dendenpixel/sumobot-must-be-the-wind/hardware/cad/v11/layout/plan.png

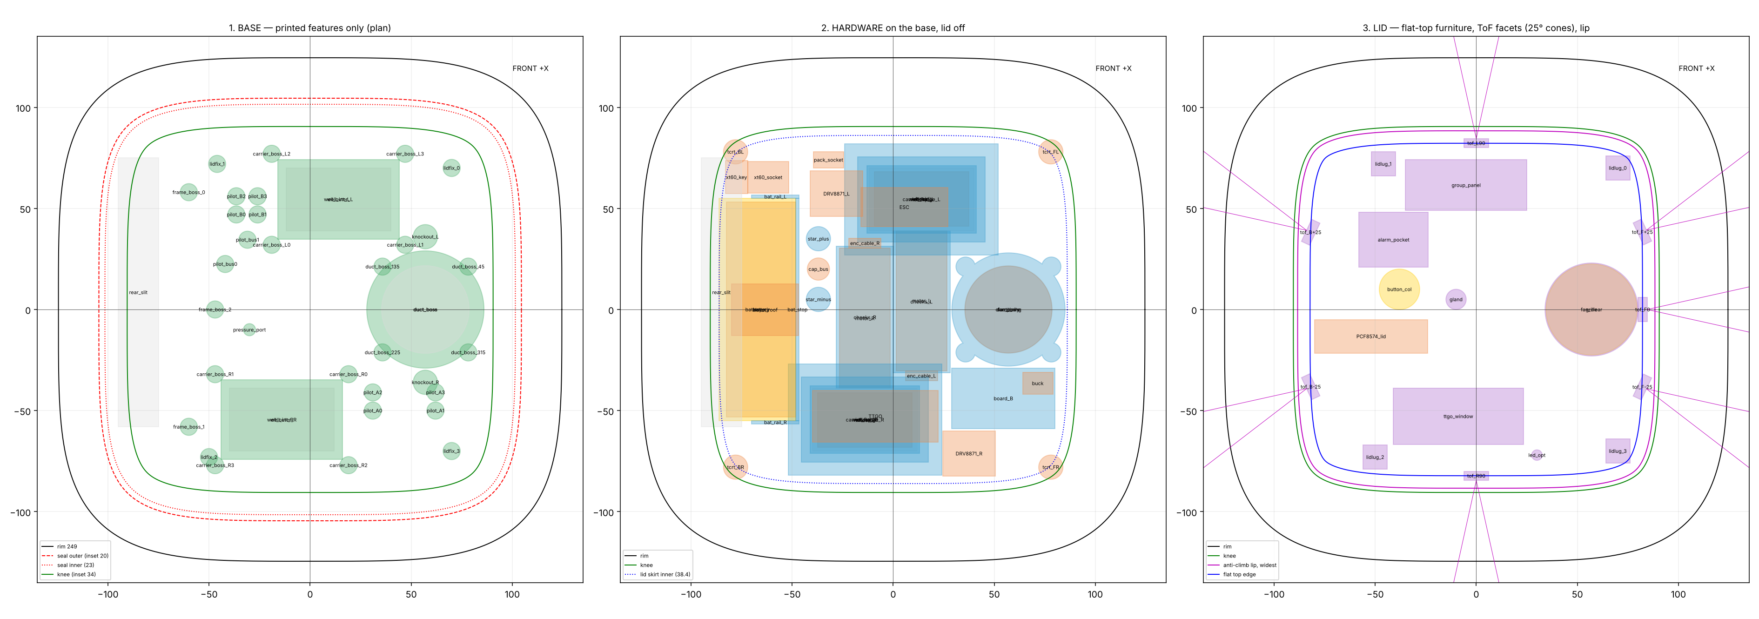
hardware/cad/v11/layout/plan.png
