dendenpixel/sumobot-must-be-the-wind/hardware/cad/v11/layout/zstack.png

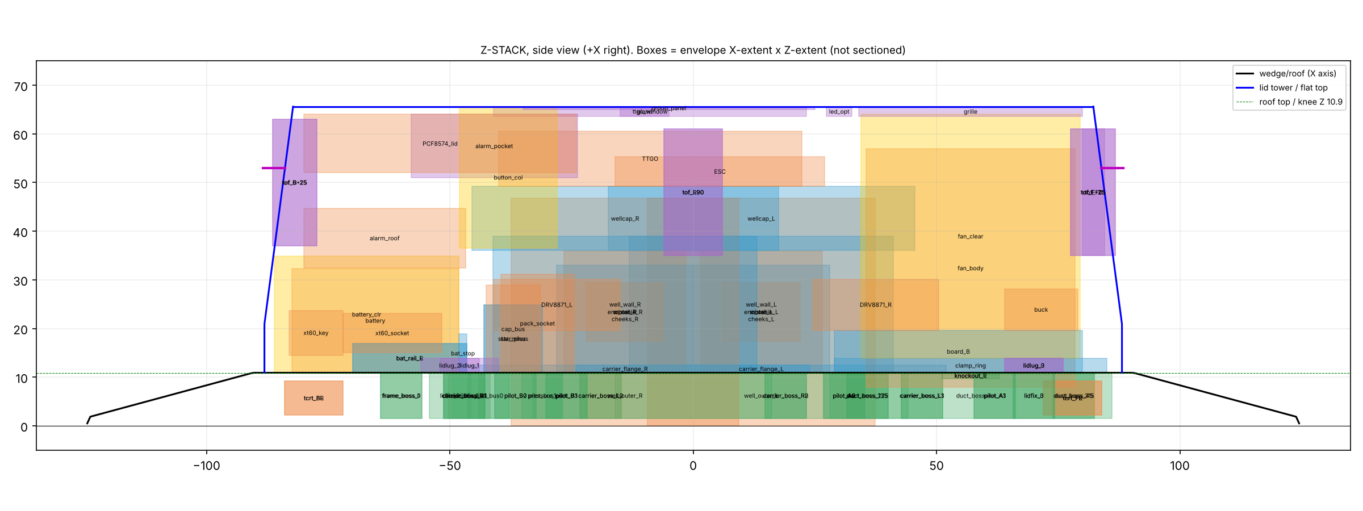
hardware/cad/v11/layout/zstack.png
