dendenpixel/sumobot-must-be-the-wind/media/first-drive/mass_765g_2026-09-23.jpg

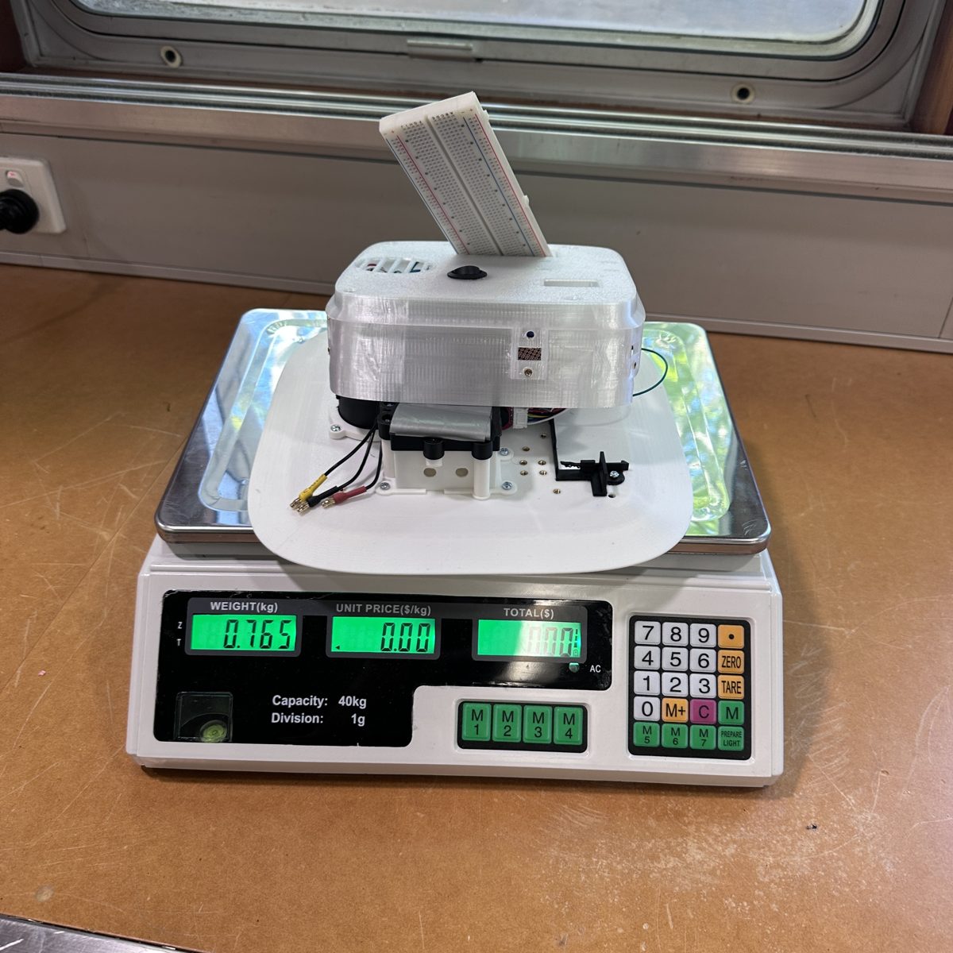
media/first-drive/mass_765g_2026-09-23.jpg
