dendenpixel/sumobot-must-be-the-wind/(list of files, cad)

Other CAD files:
hardware/cad/v11/step/v11_assembly_full.step
hardware/cad/v11/step/v11_base.step
hardware/cad/v11/stl/clamp_ring_v2_earslot_shrinkcomp.stl
hardware/cad/v11/step/v11_lid.step
hardware/cad/v11/stl/clamp_ring_v2_shrinkcomp.stl
hardware/cad/v11/stl/v11_battery_frame_v2_clip.stl
hardware/cad/v11/stl/tyre-ring-mould.stl
hardware/cad/v11/stl/sumo_wheel_hub_v6_2.stl
hardware/cad/v11/stl/v11_wellcap_L_plus2.stl
hardware/cad/v11/stl/v11_wellcap_R_plus2.stl
hardware/cad/v11/stl/v11_base.stl
hardware/cad/v11/stl/v11_lid.stl
