dendenpixel/sumobot-must-be-the-wind/docs/chassis/archive/v5-v8_POSTMORTEM.md

> **Superseded 12 Sep 2026.** The chassis is v11 (`docs/chassis/v11/START_HERE.md`). Kept for the reasoning/history.

# SumoBot chassis — v5 → v8 post-mortem and CAD handoff

**Sumo Bot · Semester 2 2026 · group project**
**Written 11 Sep 2026 at the end of an AI-assisted CAD session, for the next CAD session.**

---

## How to read this

Sections **1–9 are what you need to make decisions and build.** Sections **10–17 are why**, and the
appendices are the evidence. If you read nothing else, read §1, §2, §5 and §7.

Four CAD generations were attempted in one day. **v5 was printed and is a real object.** v6, v7 and
v8 were generated by separate max-reasoning CAD sessions and all three were rejected. Every
generated build was watertight and analytically correct — **none of them failed because the
generator was bad.** They failed because the *brief handed to the generator was internally
inconsistent*, in ways this document enumerates exhaustively so you do not repeat them.

**Two warnings about this document itself:**

1. The numbers in §15 are **corrections to numbers that were previously stated as facts.** Several
   were quoted in the v6/v7/v8 briefs and are wrong. If you find a figure elsewhere that contradicts
   §15, §15 wins.
2. This document is a *handoff*, not a requirements source. The requirements in §2 are reconstructed
   from the competition brief and the team's own planning docs. **They need confirming before any build.**

---

# 1. State of play — read this first

## 1.1 What actually exists

| Artefact | Status |
|---|---|
| **v5 chassis** (`sumo_v5_housing.3mf` + `sumo_v5_cover.3mf`) | **Printed. Weighs 267 g.** Has three defects that make it unusable as-is — see §1.2 |
| v6 base | Generated, **rejected** (battery tub inside a wheel well, + 8 more) |
| v7 base | Generated, **rejected** (38 overlapping envelope pairs) |
| v7 lid | Generated, **rejected** — 31 findings (23 constraints + 8 contradictions), incl. a 90° print ledge |
| v7 lid **rev A** | Patched in-place, **best lid so far** — 10 open constraints |
| v8 base | Generated, **rejected** — 12 register findings, 9 still open |
| **A printable chassis** | **Does not exist.** |

**Three things must be settled before any CAD starts, and none of them is a measurement:**

1. **DEC-13 — the battery hatch does not work as specified.** R16 is currently unsatisfiable: the
   pack would have to rise 18.1 mm to clear the sill and has 2.64 mm of headroom. **§16.4** has the
   arithmetic and three options. *This was not noticed until the final review of this document.*
2. **DEC-14 — the tower `lean` has no agreed value.** v7/v8 used 10°, lid rev A used 5°. Everything
   above Z 20.90 depends on it, including the anti-climb lip (#31).
3. **DEC-8 — the base drills 6 lid pilots and the lid uses 4.** Freeze it in §7 first.

**There is no base/lid pair that has ever been built against the same interface contract.** v8 BASE
and v7 LID rev A are from different generations. §7 fixes this.

## 1.2 Why v5 cannot just be reprinted

Measured off the meshes directly (not read off a self-check panel):

- **The wheels do not touch the ground.** Saddle floor Z 13.35 + a Ø25 motor can holds the axle at
  Z 25.85; the wheel radius with tyre is 23.40. **Wheel bottom sits at Z +2.45.** The bot rides on
  its rim and skirt.
- **The wheel wells are open holes straight to the arena floor, inside the seal loop** — 3,599 mm²
  against a design leak budget of 382 mm². **9.4× over.** The fan, the ESC, the 30 A wiring and the
  battery upgrade were producing approximately **zero** downforce.
- **The new battery does not fit.** The pack that arrived is 106.29 mm long against a 75 mm bay —
  **31.29 mm too long.**

That is what justified the rewrite. It is also the only time in this project anyone **looked at the
geometry** rather than reading a panel of numbers, and it produced three defects four rounds of
self-checks had missed. See §17 stage 6.

## 1.3 The two gates that can delete this design

| Gate | When | Rule | Consequence |
|---|---|---|---|
| **Fan kill gate** | **14–20 Sep, i.e. next week** | `<0.9 kg gain on the scale`, or `<60 mm H₂O`, or `EDF >100 °C in 3 min` → **fan off** | The plenum is the reason this chassis is shaped the way it is. If the gate fires, the architecture becomes *990 g ballast + silicone tyres + sprung lip* and most of §7 is irrelevant |
| **First drive** | **21–25 Sep (dry run Wed 23)** | "a platform with motors and wheels driven from the ESP32: 1 m forward, stop, 1 m back, stop" | **This does not need the plenum, the lid, the ToF, the pods, the fan, the skirt or the seal.** It needs a rolling platform. |

**Read those two rows together.** Ten days before a milestone that needs only a rolling platform,
a week before a gate that could delete the downforce architecture, the effort went into a sealed
pressure vessel with six ToF sensors. **That is the real failure of 11 Sep**, and no amount of
improvement to the CAD method catches it. See §17.0.

## 1.4 Ownership

Ownership as the master plan had it on 11 Sep, since superseded: CAD and printing moved to Den.

## 1.5 The next 48 hours — do these before any CAD

Four of them are caliper work and take under an hour total. Three of them **block real design**.

| # | Action | Blocks | Time |
|---|---|---|---|
| 1 | **Weigh both motors, one wheel with tyre, the ESC** | 330 g of the mass budget rests on seller estimates; **motors alone are 190 g = 20 % of the robot**, and the old pair measured 39.29 mm (310-class, not the assumed 371) so they are probably lighter | 2 min |
| 2 | **Measure `tyre_w`** (tyre width on the wheel) | Well Y depth, wellcap size, and **check D5 — which "passed" in v8 only because `tyre_w = 30.0` was assumed** | 1 min |
| 3 | **Measure `btn_panel_t`** (the panel thickness the power button's snap clips grip) | The button mount entirely. No hole tuning fixes a clip-range miss | 1 min |
| 4 | **Measure the bare TCRT5000** (desoldered off the module) | Corner pod pocket depth has **0.10 mm of margin** on the datasheet figure | 2 min |
| 5 | **Measure the wheel's CAD bore value** | Turns `hole_shrink = 0.21` from an estimate into a constant | 1 min |
| 6 | **Confirm the PCF8574 count** — one, not four | Decides whether the electronics fit on the roof at all | ask |
| 7 | **Confirm the TTGO is physically on hand** | Rule-mandated part; never confirmed by anyone | look |
| 8 | **Print the hole-shrinkage coupon** (4.00 / 4.15 / 4.30) | Sets `hole_shrink` for every other number on the bot | 20 min print |

---

# 2. Requirements

**This section did not exist in any previous brief.** Every number that follows in §5–§9 is a
*specification* — a value chosen to satisfy one of these. If a spec and a requirement conflict, the
requirement wins and the spec gets recomputed. Nothing gets built that does not serve a row here.

## 2.1 Rule-mandated — non-negotiable, checked by staff

| ID | Requirement | Source | Verified by |
|---|---|---|---|
| **R1** | **Mass ≤ 1000 g.** Working target 985–995 g | competition brief, "these will be checked!" | scale at weigh-in |
| **R2** | **Fits 250 × 250 × 250 mm**, including skirt and EDF guard. Build to 243 mm | competition brief | box check |
| **R3** | **Own chassis, built from scratch.** No published designs | competition brief | inspection |
| **R4** | **TTGO ESP32 controls the vehicle** | competition brief | demo |
| **R5** | No commercial boards **except the motor controller** | competition brief | inspection |
| **R6** | **Must indicate a detected opponent** on the display or a dedicated LED | competition brief | demo |
| **R7** | **Must clearly show the group number** on the robot | competition brief | inspection |
| **R8** | Must not drive outside the white line | competition brief | bout |

> **R6 and R7 have physical CAD consequences and were nearly deleted.** The group-number panel
> (60 × 25 × 0.6 recess at (20, 0) in the flat top) appears in the v7/v8 lid brief **only as
> failure #27** — "Group panel overlaps the EDF grille by 18.5 mm". A reader resolving #27 by
> deleting the panel fails R7. The opponent LED (Ø5.2 at (−20, 0)) is likewise a single line.
> **Neither is optional.**

## 2.2 Functional — how it wins

| ID | Requirement | Source | Spec that serves it |
|---|---|---|---|
| **R10** | Push a stationary object out of a 1 m ring, **fast** — the push-out time seeds the competition bracket | brief: 30 % functional + 25 % competition; time seeds the bracket | downforce plenum, μ ≥ 1.0 tyres, ballast to 990 g |
| **R11** | Find the opponent anywhere in the ring | brief: "must find any other robot" | ToF array (DEC-6) |
| **R12** | Detect the white line and not self-out | brief | 4 corner line sensors (DEC-7) |
| **R13** | **Get under the opponent** — "angled front helps in pushing/flipping"; last year's winner ran one print layer off the ground | competition brief hints + an early practical | the 15.14° full-perimeter wedge, rim lip underside Z 0.50 |
| **R14** | **Resist being lifted/wedged.** This, not tipping, is the real loss mode — tipping a 1 kg bot with a Z 21 mm CG needs >120 N | v6 review §7 | anti-climb lip, hard rim, low CG |
| **R15** | Survive a 3-minute bout on one battery charge | strategy | 2200 mAh gives ~6.6 min at 80 % DoD — **satisfied, not a constraint** |
| **R16** | **Battery swappable between bouts without removing the lid** | Den, 11 Sep, verbatim: *"you don't need a latch… You just need a small rectangle slit the battery can slide out"* | rear hatch, sill Z 22.0, 120 wide × 26 tall |
| **R17** | **As bottom-heavy as practical** | Den, 11 Sep | battery in the lowest compartment; see §2.4 |

## 2.3 Manufacturing — these have broken builds before

| ID | Requirement | Why |
|---|---|---|
| **R20** | **No support material anywhere except one declared annulus.** | Den snapped rib legs peeling PLA support off a previous print. This is the reason both parts print upside-down |
| **R21** | **No up-facing ledge and no overhang steeper than 55° from horizontal** in the declared print orientation | Failure #19 created a 1.763 mm, 90° up-facing ledge and broke R20 entirely |
| **R22** | Base fits a 250 × 250 bed with no brim and no skirt | It is exactly at the limit. The only sanctioned fallback is rim semi-axis 125 → 120, which **re-derives every radius in §5** — it is a full re-solve, not a tweak |
| **R23** | **The base is not split.** It is the pressure vessel | |
| **R24** | Every printed hole carries `hole_shrink` | This printer prints holes ~0.21 mm under nominal |

## 2.4 Design drivers that are *not* requirements

State these as preferences so they can be traded, not defended as if they were rules.

- **Centre of gravity.** Den asked for bottom-heavy. The v6 review measured **CG Z 24.78 → 21.18 mm
  at identical mass** from layout alone; the single biggest move was **getting the PCB off the Z 40
  posts (−1.84 mm)**. *But the same review is explicit that **CG is not the loss mode** — tipping
  needs >120 N; the real loss is being wedged and lifted (R14).* Spend effort on the lip and the rim
  before spending it on the CG.
- **"Small core, big skirt."** Den, 11 Sep: the middle should be as small as possible and the skirt
  as large as possible, for downforce area. Downforce = ΔP × A, so area is linear and free.
- **Ballast is the strategy.** Every gram to 990 g is unconditional normal force that does not
  depend on the fan, the skirt or the suction ruling. See §6.4 — headroom is currently **~23 g**,
  down from 75 g, and **the ballast pockets have been lost from the design** (§16.2 LOST-4).

---

# 3. Schedule — the clock this sits in

**Today is Friday 11 Sep 2026.**

| Dates | Must ship | Gate |
|---|---|---|
| 7–13 Sep | PCB workshop; **chassis v1 printed**; harness; first code drop; band tyres; μ test | motors keep/buy |
| **14–20 Sep** | Fan rig on a kitchen scale + U-tube manometer; chassis v2; silicone sleeves; closed-loop 1 m | **FAN KILL GATE** |
| **21–25 Sep** | **FIRST DRIVE** (dry run Wed 23) | — |
| 26 Sep–2 Oct | Line + ToF + FSM; push-out timing; skirt v2 | push-out < 3 s |
| 3–9 Oct | Fan tuning, CAL mode, mock bouts; **code freeze Fri 9 Oct** | weigh-in ≤ 995 g |
| 12–14 Oct | **competition** | — |

The chassis serves the push-out performance and the competition, and the first drive needs only a
rolling platform. Weigh CAD polish against that before spending another day on it.

---

# 4. What this robot actually is

**No previous version of this document described the object.** A cold reader could not draw it.
Here it is.

## 4.1 One paragraph

The robot is a **250 × 250 mm superellipse ("squircle") disc, ~66 mm tall, in two printed shells.**
The **BASE** is a sealed pressure vessel: a continuous 360° wedge skin rising at 15.14° from a knife
rim at the floor to a flat roof at Z 10.90. Underneath that roof is the **PLENUM** — a closed
cavity, sealed against the arena floor by a silicone skirt in a groove, evacuated by a 40 mm EDF
through a Ø58 duct at (52, 0). The pressure difference pulls the whole robot down: *Downforce =
ΔP × A*. Above the roof is the **BAY**, which carries the battery, the ESC, the logic board and the
motors. The **LID** drops over the base, encloses the bay, and carries the ToF sensors, the display
window, the EDF grille and the anti-climb lip. The two drive wheels sit in **wheel wells** — sealed
boxes that are open to the arena below and capped above, so the wheels can reach the floor without
opening a hole into the plenum.

## 4.2 The parts

| Part | What it is | Printed | Mass (v8/v7A) | Attaches how |
|---|---|---|---|---|
| `sumo_v8_base` | Wedge + plenum + roof + wells + motor cheeks + duct + battery tub + corner pods | PLA, **roof-face down** | 136.2 g | — |
| `sumo_v8_wellcap` ×2 | Open-bottom box over each wheel-well wall stack, sealing the well from the bay | PLA, open side down | ≤ 8 g ea | 4 × M3 into well wall-top inserts |
| `sumo_v8_lid` | Skirt + leaning tower + flat top + anti-climb lip + all sensor/display apertures | PLA, **flat top down** | 104 g | 6 × M3 button head into base pilots |
| `sumo_v8_hatch` | Flush rear panel filling the battery aperture | PLA, flat face down | ≤ 8 g | 2 × M3 thumb screws |

## 4.3 The sealed-volume topology — the rule that governs everything

> **The KNEE (RIM INSET 34.0, Z 10.90) is the sealed boundary.**
> **Inboard** of the knee, the roof plate separates the **PLENUM** (below, at negative pressure)
> from the **BAY** (above, at ambient).
> **Outboard** of the knee, the wedge underside faces **ATMOSPHERE**.
> No feature outboard of the knee can reach the bay without a sealed penetration through the roof.

This one paragraph explains failure #13 (a corner-pod wire hole was put in the pod ceiling, which
faces atmosphere, not the bay), why corner features are hard, and why an opening in the lid above
Z 10.90 costs **zero** downforce — the bay is already at ambient. It was never written down.

## 4.4 Two leak budgets, not one

They are independent and were repeatedly conflated.

| Budget | Path | Cap | Why |
|---|---|---|---|
| **Skirt leak** | arena floor → atmosphere, at the seal line | **382 mm²** design | Sets how much ΔP the fan can hold. v5 measured **3,599 mm²** because of the open wells |
| **S2 bay leak** | arena floor → electronics bay | **≤ 60 mm²** | Keeps grit and suction out of the bay. Permitted: the 4 sensor wire holes (4 × Ø4.21 = 55.7 mm²) |

## 4.5 Assembly and service sequence

Nobody ever walked this, which is why the battery hatch arrived mid-build as a new requirement.

1. Heat-set all M3 inserts into the base (roof pilots ×6, well wall tops ×4, duct ×4, pod ×4) —
   **driver access from above, before anything else goes in.**
2. EDF into the duct collar, 4 × M3.
3. Motors into the cheeks, faceplate screws through the well inner wall, 17.00 c-c.
4. Wheels on, from outside the well.
5. Wellcaps down over each well, 4 × M3 each, onto 3 mm EPDM foam compressed to 1.5.
6. Board A (power/ESC) and Board B (logic/TTGO) onto flush pilots with 6 mm M3 nylon standoffs.
7. Battery into the tub, velcro strap through the two 12 × 3 slots.
8. Silicone skirt strips glued into the three grooves (base inverted).
9. Lid on, 6 × M3 button head. Harness = **one 4-way JST-XH** through the lid gland.
10. **Service:** battery comes out through the rear hatch with the lid on — unplug XT60, slide out,
    plug in the fresh pack. Nothing else is field-serviceable without removing the lid.

---

# 5. Frame, datums and the geometry that governs everything

## 5.1 The coordinate frame

**This was never stated in any brief and had to be reverse-engineered three separate ways.**

```
Units      millimetres
Origin     the plan centre of the base superellipse
Z 0        THE ARENA FLOOR.  +Z is up.
+X         robot FRONT (the 0° ToF bearing).  +Y is robot LEFT.
Axle       both drive wheels share one axle along the Y axis, at Z 23.40
```

Everything in this document is in that frame **unless a print note says otherwise** — and print
notes do, because both parts print upside-down. "Z 10.90 roof face on the bed" means *the part is
inverted and the surface that is at Z 10.90 in the design frame touches the build plate.*

## 5.2 The RIM and what "RIM INSET" means

The outer curve is a **superellipse (squircle) of exponent 4**:

```
|x/125|^4 + |y/125|^4 = 1        →  250 × 250 mm
r = 125.000 on the axes         r = 148.651 on the 45° diagonals
```

> **"RIM INSET d" = that curve offset `d` mm inward along its LOCAL NORMAL.**
> It is **not** a radial scale and **not** a scaled superellipse. On the diagonals, a normal offset
> and a radial offset give different answers everywhere except at 0° and 45°, where the normal
> happens to be radial.

Generate it, never type it:

```python
import numpy as np
A = 125.0
def inset_curve(d, N=200000):
    t  = np.linspace(0, 2*np.pi, N, endpoint=False)
    ct, st = np.cos(t), np.sin(t)
    r  = A/(np.abs(ct)**4 + np.abs(st)**4)**0.25
    x, y = r*ct, r*st
    gx, gy = 4*x**3, 4*y**3            # outward normal = grad of the implicit form
    L = np.hypot(gx, gy)
    return x - gx/L*d, y - gy/L*d
```

## 5.3 The verified radius table — every outer curve on this bot

Independently recomputed at 2 M samples. **All fourteen values PASS exactly.**

| Curve | RIM INSET | r on the axes | r on the 45° diagonals | **local radius of curvature at the corner** |
|---|---|---|---|---|
| **RIM** (superellipse a = 125) | 0 | 125.000 | 148.651 | **49.550** |
| seal loop OUTER face | 20.0 | 105.000 | 128.651 | 29.550 |
| seal loop INNER face | 23.0 | 102.000 | 125.651 | 26.550 |
| **KNEE** = base collar OUTER | 34.0 | 91.000 | 114.651 | **15.550** |
| base collar INNER | 36.0 | 89.000 | 112.651 | 13.550 |
| lid skirt OUTER | 36.4 | 88.600 | 112.251 | 13.150 |
| lid skirt INNER | 38.4 | 86.600 | 110.251 | 11.150 |

Why the diagonal column is exact rather than approximate: at θ = 45° the gradient is ∝ (x³, y³) with
x = y, so **the outward normal there is also radial**. Hence `r_diag = 148.651 − d` exactly, and
`r_axis = 125 − d` exactly.

### The fact this table was missing, and it is the important one

```
R_corner(inset d) = 2·125/(3·2^0.75) − d = 49.550 − d
```

**The corner radius of curvature collapses linearly with inset — from 49.55 mm at the rim to
11.15 mm at the lid skirt inner.** Nearly every corner-fit error in the whole project comes from
using one wrong value of this. See §15.

**The offset curve never cusps.** Self-intersection begins at inset = 49.550 mm; the deepest inset
used anywhere is 38.4, leaving 11.15 mm of margin. Not a concern — but worth knowing the limit
exists before someone proposes INSET 50.

## 5.4 NEVER interpolate between the axis and diagonal columns

Almost nothing sits exactly on an axis or exactly at 45°. Linear interpolation between the two
columns is **wrong by up to 4.88 mm** (at INSET 34, worst at polar 18.5°). That single error is
failure #16: Board B's corner at (−78, +88) is at polar 131.55°, r 117.593, where the knee is
**113.502** — so the board overhangs by **4.09 mm**, not the 3.59 the register recorded.

**Use the sampled table in Appendix B, or generate the curve. Never interpolate.**

## 5.5 The wedge profile — the primary structure, previously undocumented

It existed only as one sampled point inside the explanation of failure #2.

```
Rim lip underside      Z 0.50  at RIM INSET 0
Rim lip top edge       Z 1.70  at RIM INSET 0        (skin 1.2)
Ramp                   straight, 15.14° along the local normal, IDENTICAL at every bearing
Gradient               tan(15.14°) = 0.27057
Top surface Z(inset)   = 1.70 + 0.27057 · inset      → Z 10.90 at the KNEE (inset 34)
Underside   Z(inset)   = 0.50 + 0.27057 · inset      → Z  9.70 at the KNEE
ROOF TOP               Z 10.90 = the knee height = the base/lid datum
```

Cross-checks that close: the print note "support annulus **1.2 to 10.4 mm** tall" matches the
underside running Z 0.50 → 9.70 above a bed at the roof plane; and failure #2's "at inset 18 the
wedge skin underside is Z 5.37" matches `0.50 + 0.27057 × 18 = 5.37` (the brief used 5.91 for the
skin underside at inset 20 — consistent).

## 5.6 The lid tower profile — also previously recoverable only by arithmetic

```
SKIRT   a VERTICAL wall, outer RIM INSET 36.4, inner 38.4, from Z 10.90 to Z 20.90
TOWER   above Z 20.90 the outer face leans INWARD:
            outer_inset(Z) = 36.4 + (Z − Z_TOWER_DATUM)·tan(lean)
        *** Z_TOWER_DATUM = 20.90.  NOT 10.90. ***
FLAT TOP  a plane at Z 65.6 (EDF top 62.0 + 2.0 clear + 1.6 skin → grille inner 64.00)
          At lean 10°: meets the tower at RIM INSET 44.282
                       → r 80.718 on the axes = 161.44 mm across; r 104.369 on the diagonals
          At lean  5°: RIM INSET 40.310 → r 84.690 = 169.38 mm across
```

> **`Z_TOWER_DATUM = 20.90` is the single highest-value line in this document.**
> v7 used 10.90, which put the tower at INSET 38.16 where the skirt was at 36.4 — a **1.763 mm
> up-facing ledge with a 90° overhang**, which broke the no-support print strategy (R20/R21) for the
> entire part. That is failure #19, and the corrected datum was never written down in prose
> anywhere. **Write it into the parameter file as a named constant.**

The "158 mm unsupported bridge" in the print notes is exactly this. **The original 158.06 figure was
computed with the WRONG datum (Z 10.90).** Recomputed: **161.4 mm at 10° lean, 169.4 mm at rev A's 5°.**
Either way it is a bridge no printer will span — which is why the lid prints flat-top-down.
*This is a live example of the datum error propagating into a "verified" number: it survived an audit
because the arithmetic was self-consistent against a wrong input.*

---

# 6. Parameters

Three tables. **Never mix them.** The third is expressions only — no literals.

## 6.1 MEASURED — trust these, they came off a caliper or a scale

| Parameter | Value | Source | Date |
|---|---|---|---|
| `hole_shrink` | **0.21 mm** — this printer prints holes **under** nominal; **ADD to every hole/bore/pilot diameter** | two wheels measured 3.81 / 3.77 in a nominally 4.00 bore | 11 Sep |
| `print_factor` | **0.82** — printed mass = 0.82 × (STL volume × 1.24 g/cm³) | v5 chassis: 324.5 g solid, **weighed 267 g** → 0.8228 | 11 Sep |
| `wheel_od` | **46.80** — with the tyre fitted | calipered | 11 Sep |
| battery | Ovonic AIR 3S **2200 mAh 120C**, **106.29 × 34.39 × 21.46**, **151.2 g**, **XT60** | calipered + weighed + barcode | 11 Sep |
| battery leads | discharge ~132 mm, balance ~75 mm | calipered | 11 Sep |
| ESC | LittleBee 30 A. Board 35.1 × 18.16 × 5.55; **envelope 41.82 incl. heatshrink**; **80 mm power leads** | calipered | 11 Sep |
| XT60 panel half | body 15.56 × 8.13, **ridge 9.15**, height 20.31 → cut-out **15.9 × 8.4 (body-sized)** | calipered | 11 Sep |
| power button | body **Ø18.51** → hole Ø18.70 + shrink. Snap-fit, two side clips | calipered | 11 Sep |
| LiPo alarm | **33.22 × 25.72 × 12.21**, no fixings, buzzer domes 12.20 c-c | calipered | 11 Sep |
| VL53L0X ToF | board 24.78 × 10.32 × 3.18; holes **19.79 c-c**, Ø2.94 (M2.5 clearance) | calipered | 11 Sep |
| ToF field of view | **25°** cone | ST datasheet | — |
| TCRT5000 **module** | **31 × 14** | supplier listing | — |
| M3 heat-set insert | knurl Ø4.48 × 4.96 long → **pilot Ø4.15 (+shrink) × 6.0 deep**, boss Ø8.5 | calipered | 11 Sep |
| motor faceplate | **17.00 c-c**, tapped M3; boss Ø7.05; shaft Ø4.10 with a 3.46 flat | calipered | 11 Sep |
| **old** motor pair | body **39.29 mm**, can 17.53 → a **310-class, not the assumed 371** | calipered | 11 Sep |
| arena | 1 m diameter black circle, white boundary line | competition brief | — |
| rule box | 250 × 250 × 250 mm, **1 kg max** | competition brief | — |

## 6.2 ASSUMED — each row names the test that retires it

**Everything in §6.3 may depend on these.** *One caveat: `hole_shrink` sits in §6.1, but its provenance
is a bore that was only* nominally *4.00 — it stays provisional until the shrinkage coupon lands.*

| Parameter | Assumed | What it blocks | Test that retires it |
|---|---|---|---|
| **`tyre_w`** | 30.0 | Well Y depth, wellcap, **and D5** — v8's D5 pass is *conditional on this number* and void if it changes | caliper the tyre on the wheel |
| **`motor_len`** | 65.0 | Cheek segment coverage. Old pair was 39.29; new pair never arrived | caliper the new motors |
| **motor mass** | 95 g each = **190 g = 20 % of the whole robot** | The entire mass budget and the ballast headroom | **put them on a scale** |
| **`btn_panel_t`** | 2.0 | The button mount entirely — a snap-fit only latches inside its clip range | caliper the clip gap |
| **bare TCRT5000** | 10.2 × 5.8 × **7.0** (Vishay datasheet) | Corner pod pocket — **0.10 mm of margin** at 7.0 | caliper a desoldered sensor |
| **EDF static pressure** | **800 Pa** | **The entire downforce claim** — see the warning below | **mid-Sep scale + manometer rig** |
| wheel CAD bore | unknown | Confirms `hole_shrink` | check the wheel's source file |
| TTGO on hand | assumed yes | R4 — rule-mandated | look at it |

> ### ⚠ 800 Pa is an assumption that has been quoted as a fact
> Every downforce number in every prior document rests on it. **It has never been measured.** The
> course coordinator explicitly warned that the competition timber plate is not perfectly smooth and
> to expect side-leak losses. And the mid-Sep kill gate is **0.9 kgf**, which on the 32,734 mm²
> plenum is only **270 Pa** — so the design is claiming **3× the survival threshold** from an
> unmeasured figure that an authority has already called optimistic. Move 800 Pa out of every
> "hard facts" table until the rig test lands.

## 6.3 DERIVED — expressions only, computed never typed

**Chosen constants** (design choices, not measurements — each needs a REQ id):

```python
motor_bore      = 25.3    # cheek half-round bore, nominal (coupon: 25.1/25.3/25.5)
cheek_wall      = 1.6
motor_centre_x  = 14.0    # track 110 c-c -> wheel centres (14,55) and (-14,-55)
clr_x, clr_y    = 3.0, 2.0    # wheel-to-well clearance, X and Y
lean            = ???     # UNDECIDED - see DEC-14.  10 deg in v7/v8, 5 deg in lid rev A
Z_TOWER_DATUM   = 20.90
Z_ROOF_TOP      = 10.90
flat_top_z      = 65.6
```

**Derived — expressions only:**

```python
axle_z      = wheel_od / 2                  # = 23.40   AN IDENTITY, not a free number
well_x      = wheel_od + 2*clr_x            # = 52.80   the wheel's DIAMETER lies in X
well_y      = tyre_w   + 2*clr_y            # = 34.00   the tyre's WIDTH lies in Y
clr_x, clr_y = 3.0, 2.0
cheek_half  = (motor_bore + hole_shrink)/2 + cheek_wall      # 12.755 + 1.6 = 14.355
cheek_outer = abs(motor_centre_x) + cheek_half               # 14.0 + 14.355 = 28.355
wedge_top_z(inset)  = 1.70 + tan(15.14°)*inset               # 10.90 at inset 34
wedge_under_z(inset)= 0.50 + tan(15.14°)*inset               #  9.70 at inset 34
tower_inset(z)      = 36.4 + (z - Z_TOWER_DATUM)*tan(lean)   # Z_TOWER_DATUM = 20.90
R_corner(inset)     = 49.550 - inset                         # corner radius of curvature
r_axis(inset)       = 125.000 - inset
r_diag(inset)       = 148.651 - inset
printed_mass(vol_cm3) = 0.82 * vol_cm3 * 1.24
```

Plus global rules asserted before any geometry is generated:

```python
MIN_WALL   = 1.2     # any wall between a cavity and a surface
MIN_GAP    = 0.8     # any non-fused envelope pair
MIN_LAND   = 1.5     # remaining material around any hole or counterbore
MAX_OVERHANG = 55.0  # degrees from horizontal, in the PRINT orientation
BED        = (250.0, 250.0)
MASS_MAX   = 1000.0
```

**Failures #2, #21, #33, #36, #37, #40 are all `MIN_LAND` violations. Failures #41, #42, #43 are all
`MIN_GAP` violations (gaps of 0.00, 0.18 and 0.27 mm).** Nine of 46 register entries — one fifth —
would have been structurally impossible with those two constants asserted.

## 6.4 The mass budget — this existed in the project and was never in the CAD brief

Limit **1000 g**, working target **985–995 g**.

| Item | Qty | g | Status |
|---|---|---|---|
| Chassis printed (v5, top + base) | 1 | **267.0** | **WEIGHED 11 Sep** |
| PETG small parts | — | 45 | estimate |
| Skirt silicone + adhesive | — | 20 | estimate |
| M3 inserts + fasteners | ~25 | 30 | estimate |
| Motors | 2 | **190.0** | **seller estimate — the single largest uncertainty** |
| Wheels with tyre | 2 | 74 | estimate |
| **Battery** | 1 | **151.2** | **WEIGHED 11 Sep** |
| EDF 40 mm | 1 | 40 | estimate |
| ESC | 1 | 25 | estimate |
| Expansion PCB + modules | 1 | 65 | estimate |
| Alarm, button, XT60, wiring | — | 60 | estimate |
| **TOTAL** | | **≈ 967** | |
| **Ballast headroom to 990** | | **≈ 23 g** | **was 75 g** |

**Honest note on the v8 mass claim.** Prior drafts said "base 136 g + lid ~110 g = ~246 g against
v5's 267 g — no regression, ~21 g recovered." That comparison is wrong: it omits **two wellcaps
(≤ 8 g each) and the hatch (≤ 8 g)**. The like-for-like figure is `136.2 + 104 + 16 + 8 ≈ 264 g`.
**There is no meaningful mass recovery, and ballast headroom stays at ~23 g.** Lid mass is
separately recorded as 104 g (measured), ~110 g (estimate) and 85 g (a target #30 says was never
justified) — pick one, record which.

---

# 7. THE INTERFACE CONTRACT — freeze this before either part is built

**This is the file that did not exist, and its absence is why the base drills 6 lid pilots while the
lid uses 4.** Base and lid were designed by two independent sessions with no shared document.

> **RULE: neither the base session nor the lid session may change a number in this section.**
> A change here is a *contract revision*: it gets a version number, and **both parts rebuild against
> it.** Paste this block **verbatim** into both briefs. Do not retype it from memory.

```
I0  FRAME. mm, Z up, origin on the ARENA FLOOR at the base plan centre, +X forward, +Y left.
    RIM is the superellipse |x/125|^4 + |y/125|^4 = 1: 250 x 250, r 125.000 on the axes,
    r 148.651 on the 45 deg diagonals. "RIM INSET d" = that curve offset d inward along its
    local NORMAL (not a radial scale). Verified radii, axis/diagonal:
      20 -> 105.000/128.651 · 23 -> 102.000/125.651 · 34 -> 91.000/114.651
      36 ->  89.000/112.651 · 36.4 -> 88.600/112.251 · 38.4 -> 86.600/110.251
    Corner radius of curvature at inset d = 49.550 - d.
    NEVER interpolate between the axis and diagonal columns: max error 4.88 mm.
    Print these seven measured pairs in the self-check.

I1  KNEE = RIM INSET 34.0. The base wedge stops here at Z 10.90. Outboard of the knee is BASE
    and faces ATMOSPHERE. Above Z 10.90 and inboard of the knee is LID/BAY.

I2  LEVELS. Rim lip underside Z 0.50. Pan underside Z 1.50. Plenum Z 1.50..9.70. Roof plate
    Z 9.70..10.90. ROOF TOP = Z 10.90 = knee height. Nothing below Z 0.50; nothing below
    Z 1.50 except the rim lip within 12 mm of the rim.

I3  JOINT. Base COLLAR: wall 2.0, outer face ON the knee (INSET 34.0), inner face INSET 36.0,
    Z 10.90..16.90. Lid skirt sits INSIDE it: outer INSET 36.4, inner INSET 38.4, from
    Z 10.90 up. Radial clearance 0.40.
    Z_TOWER_DATUM = 20.90 -- the lid wall is VERTICAL from 10.90 to 20.90 and leans only above.
    HARD RULE: no lid surface is ever radially proud of the base.

I4  LID FIXINGS x6: vertical Ø(4.15+hole_shrink) M3 heat-set pilots 6.0 deep, drilled DOWN
    from Z 10.90 (floors Z 4.90), each in a Ø8.5 boss hanging BELOW the roof through the
    plenum (Z 1.50..10.90) so the roof top stays flush.
    At (+74,+74) (-74,+74) (-74,-74) (+74,-74) (0,+82) (0,-82).
    *** SIX. The lid must mate SIX. v7 lid rev A used four -- that mismatch is UNRESOLVED
        and is DEC-8 in section 16. Settle it before either part is generated. ***

I5  WHEEL WELLS x2, OUTSIDE the plenum, each sealed in its own right.
    +Y well interior X -12.40..40.40 (well_x=52.80, wheel centred X 14), Y 38.00..72.00
    (well_y=34.00, wheel centred Y 55). -Y well is the POINT-mirror.
    Open to the arena below, capped above by the wellcap.
    Well seal wall: 1.2 inner wall + 3.0 seal wall -> outer face +4.2 all round:
    +Y outer X -16.60..44.60, Y 33.80..76.20, Z 1.50..10.90.
    Above Z 10.90 the well walls are 1.2 thick to Z 39.0 and carry FOUR Ø8.5 local bosses on
    their TOP face at Z 39.0 with Ø(4.15+hole_shrink) pilots 6.0 deep, at (-14.5,55) and
    (42.5,55) for +Y plus the two mid-span positions on the Y walls (point-mirror for -Y).

I6  WELLCAP: outer top Z 49.2, plan within X -18..46, Y 33..77 (+Y; point-mirror for -Y).
    Lid inner >= Z 52.0 over those rectangles. Its top is a flat pad for LIGHT items only.

I7  BOARD A (power, carries the ESC): flat roof, X 20.0..77.0, Y -76.0..-36.0 (2,280 mm2).
    Four flush Ø(4.15+hole_shrink) pilots 8 mm inboard of the corners, NO printed standoffs
    -- M3 nylon standoffs 6 mm. Stack reaches Z 31.0. Lid inner >= Z 34.0.
    There is NO ESC saddle.

I8  BOARD B (logic): flat roof, X 46.6..78.0, Y 32.0..68.0 (1,130 mm2). Same flush pilots.
    TTGO socketed, USB-C facing +X. Stack to Z 31.0. Lid inner >= Z 34.0.

I9  BATTERY TUB: interior 36.0 (X) x 108.5 (Y), inner floor Z 3.90, walls 1.2, outer floor
    Z 2.70, walls to Z 13.0 ONLY. Outer X -85.00..-46.60, Y +/-55.45, with the TWO REAR
    corners (at X -85.0) chamfered 2.0 x 2.0 -- the chamfer is what keeps the tub inside the
    lid skirt. Battery 106.29 x 34.39 x 21.46 sits at X -83.80..-47.80, Y +/-53.15,
    top Z 25.36. Lid inner >= Z 28.0 over X -46..-86, Y +/-56.
    NOTE: the bay is sized with a PUFF ALLOWANCE, not a press fit. LiPos swell.
    Retain with a strap, never by pinching between walls.

I10 EDF in the duct at (52,0), EDF top Z 62.0. Lid grille inner >= Z 64.0.
    The Ø58 duct collar is centred at (52,0).

I11 KNOCK-OUTS: 2 x Ø12.0 discs in the roof at (52,+36) and (52,-36), 0.6 mm membranes,
    *** +/-36, NOT +/-35. At 35.0 the Ø12 is EXACTLY tangent to the Ø58 duct boss
        (29 + 6 = 35.0) and cannot be cut -- that is failure #41. 36 gives 1.0 clearance. ***
    NOT open, with a 0.4 mm annular score on the bay side. Default: SEALED.
    *** DO NOT DELETE THESE WITHOUT REPLACING THEM. See section 16 F5: they are the
        TUNEABLE BLEED, and a tuneable bleed is what Den told the course coordinator was his
        answer to the side-leak warning. They are also the EDF's only thermal relief path
        into the bay. The v8 ruling "delete the knock-outs" reversed a commitment made to
        staff and was recorded as a tidy-up. ***

I12 CLEARANCE ENVELOPE -- the lid's INNER surface Z must clear all of these:
      I6 wellcap rectangles >= 52.0 · I7 Board A >= 34.0 · I8 Board B >= 34.0
      I9 battery >= 28.0 · I10 grille >= 64.0 · motor cheeks (top 33.0) >= 36.0
      well walls (top 39.0) >= 42.0 · well wall-top bosses (39.0) >= 42.0
    Any miss is a FAIL -- name the rectangle and the measured minimum.
    DO NOT shrink a pocket to pass; report the conflict.

I14 BATTERY HATCH aperture, in the REAR tower centred on the -X axis.
    *** UNRESOLVED -- SEE SECTION 16 DEC-13. The spec below does NOT yet satisfy R16. ***
    Previous spec: sill Z 22.0, head Z 46.0, 120.0 wide along the tower surface; the hatch part
    fills it flush (same tower surface, 1.6 shell, 0.4 clearance, a 3.0 x 1.5 inner rebate lip,
    two Ø(3.4+hole_shrink) holes at the top edge into Ø8.5 x 6.0 inner bosses for M3 thumbscrews).
    H2 requires a clear aperture >= 112 x >= 24 so a 106.29 x 21.46 pack passes with >= 2.5 all round.
    An opening here costs ZERO downforce: the plenum is sealed below the roof and the bay is
    already at ambient.

I15 LID HARNESS GLAND: Ø10.0 hole in the FLAT TOP at (-62,0), with a Ø16 x 1.0 recess, for ONE
    4-way JST-XH (3V3, GND, SDA, SCL) to a PCF8574 breakout mounted inside the lid, which drives
    all six ToF XSHUT lines plus the LED and the button locally. Four wires, one plug, lid off in
    one action. This is the ONLY harness penetration between base and lid.

I16 NO RADIAL HOLES IN THE LID BELOW Z 38.0, except the hatch aperture and the TTGO slot.
    (This is the "Z 38 no-hole line" cited in failure #26. It is a structural band on the tower.)

I13 SEAL GROOVE, all three loops: 1.3 wide x 2.0 deep cut UPWARD from the wall underside
    (open Z 1.50, floor Z 3.50), centred in the 3.0 wall, continuous through corners, with a
    45 deg chamfer 0.4 each side on the groove mouth so print support releases.
    Main loop centreline sits at INSET 21.5, length 742.1 mm. Well loops 192.6 mm each.
```

---

# 8. The check register — what every check ID actually tests

Previous documents cited these as authority while defining almost none of them. **Preserve and
re-run all of them.**

## 8.1 Base checks

| ID | Measures | Pass criterion |
|---|---|---|
| **W1** | Wedge ramp angle sampled at **72 bearings** (every 5°), outside the pod footprints | 15.14° ± 0.25 |
| **W2** | Rim lip underside Z at 72 bearings; rim curve fidelity to the superellipse | Z 0.50 ± 0.05; curve within 0.30 |
| **W3** | Material continuity rim → knee at every 1°, outside pod pocket mouths | zero gaps |
| **C1** | Pod outer face r vs seal-loop INNER r; pod inner face r vs collar OUTER r, all four diagonals | both ≥ 1.20 |
| **C2** | Closest approach of pod influence to the rim | reaches zero before RIM INSET 8.0 |
| **C3** | Max slope anywhere on a pod or its blend | **was "≤ 20° absolute" — THIS CONSTRAINT IS IMPOSSIBLE, see §14** |
| **C4** | Measured `pod_h` at four radii across each pod | 2.50 at all of them. *If they differ, a flat top was built — wrong* |
| **S1** | Plan sections at **Z 2.0 / 5.0 / 8.0**, flood-filled from the origin, bounded by the main loop, not reaching a well or the outside | closed at all three. **Z 2.0 is the downforce area** |
| **S2** | Vertical rays on a 1 mm grid over the enclosed region: total area open from the **arena floor to the BAY** | **≤ 60 mm².** Only permitted: 4 sensor wire holes (4 × Ø4.21 = 55.7 mm²). Knock-outs must read CLOSED. Duct bore excluded (filled by the EDF) |
| **S3** | All three grooves: open at Z 1.50, closed at Z 3.50, continuous | depth 2.00 +0.10/−0.00, **zero interruptions** on the main loop |
| **D1** | (axle_z − 12.5) − 10.90 — motor bottom sits directly on the roof plate | 0.00 ± 0.05 |
| **D2** | wheel_od/2 − axle_z | **0.00** — this is the check that would have caught v5's wheels being 2.45 mm off the ground |
| **D3** | Faceplate hole c-c, both sides | 17.00 ± 0.10 |
| **D4** | Cheek outer \|X\| 28.355 → tub outer X −46.60 | ≥ 18.25 |
| **D5** | **WHEEL FIT** — clearance from the wheel envelope to the well interior on **all four sides of both wheels** | 3.0 / 3.0 / 2.0 / 2.0. Any negative is a FAIL. **This is the check v7 did not have and it is the one that killed v7** |
| **P5a** | Duct bore edge → cheek outer face | ≥ 1.5 |
| **P5b** | Ø58 collar fuses with both cheeks below Z 14.0 (declared); motor silhouette untouched | X 5.38…22.62 for +Y clear |
| **B1** | Tub outer floor Z 2.70 vs rim lip 0.50 + 2.00 | positive margin |
| **B2** | Tub outer X −46.60 → −Y well seal wall X −44.60 | 2.00 |
| **B3** | Tub rear-chamfer corners and battery corners vs the lid skirt inner curve | tub ~+0.4, battery ~+1.8 |
| **WC1** | Wellcap plan extent | within X −18…46, Y 33…77 |
| **WC2** | Wellcap ceiling underside Z 48.0 vs wheel top Z 46.8 | 1.20 |
| **I4/I5/I7/I8** | Six lid pilots · four well wall-top bosses · eight board pilots + roof flatness between them | positions reported, roof flat |

## 8.2 Lid checks

| ID | Measures | Pass criterion |
|---|---|---|
| **SK1** | Skirt outer as a RIM INSET at 36 bearings | 36.4 ± 0.15 |
| **SK2** | Skirt bottom flatness | flat and horizontal at Z 10.90 ± 0.05 |
| **SK3** | The anti-climb lip's widest point expressed as a RIM INSET | **≥ 36.4** — i.e. inboard of the base collar (INSET 34.0) by **≥ 2.4** |
| **SK-STEP** | The step between the skirt outer face and the tower outer face at Z 20.90 | **0.000.** Any up-facing ledge is an R21 failure |
| **F1/F2/F3** | Six lug hole centres · flat land per lug · no lug outboard of the skirt inner face | ±0.2 · ≥ Ø8.0 · none |
| **H1/H2/H3** | Hatch outer surface continuity · clear aperture · what the aperture must not cut | step ≤ 0.3 · ≥ 112 × ≥ 24 · neither the skirt nor the lip |
| **T1** | Six ToF slot centres, yaws, pocket depths, measured pilot spacing | 19.79 c-c |
| **T2** | Covered arc and **every** blind arc at 25° per cone | **report, do not adjust the angles to close a gap** |
| **A1** | LiPo alarm buzzer vent c-c | 12.20 ± 0.2, neither internally blocked |
| **C5** | Button panel: counterbore on the flat top's underside to a remaining thickness of exactly `btn_panel_t`; keep-out Ø20 cylinder Z 33…64 under the hole | remaining thickness exact; keep-out clear of I7/I8 |
| **OVERHANG** | Steepest overhang for a **top-down** print (flat top on the bed), including the lip's 45° face | **≤ 55° from horizontal, everywhere.** Report the worst location **by name** |

## 8.2a Prompt block names (so `P4`, `P5a`, `I5` etc. resolve)

The base brief is organised in blocks: **P1** wedge · **P2** corner pods · **P3** plenum and seals ·
**P4** drive (cheeks, faceplate, axle) · **P5** duct · **P6** bay furniture · **P7** wellcap.
The lid brief: **C1** skirt/tower/flat top · **C2** fixing lugs · **C3** battery hatch · **C4** openings ·
**C5** button panel. `I0`–`I13` are the shared interface items in §7.

**Namespace warning.** Several IDs collide across sections. When citing, prefix:
`CHK-` for §8 checks (CHK-D5, CHK-C3, CHK-A1, CHK-B1, CHK-F1) · `TAX-` for §13 classes
(TAX-A1, TAX-B1, TAX-C3) · `DEC-` for §16.3 decisions (DEC-5, DEC-8) · `LOST-` for §16.2
(LOST-1 … LOST-7). Bare `#n` always means a §12 failure row; bare `R n` a §2 requirement.

## 8.3 Both parts

| Check | Criterion |
|---|---|
| **Plan-overlap map** | Every envelope pair rasterised and tested. **Zero overlap outside the declared fusions**, and every fusion named *in advance* |
| Watertightness | 0 open edges, every part |
| Mass | at 1.24 g/cm³ solid **and** at the 0.82 printed factor |
| The seven interface radii | measured on the exported mesh, axis and diagonal |

---

# 9. The v8 verified layout table — **start here, do not re-solve from zero**

This is the artefact that worked. **28 envelopes rasterised at 0.5 mm, all 378 pairs tested → zero
overlaps outside six declared fusions.** It took v7's 38 overlapping pairs down to 5 reported
"overlaps", of which only 2 were real declaration artefacts. Every prior draft of this handoff
*referenced* this table and did not *contain* it, which would have forced the next session to invent
a different layout and make the v8 failure register unreadable.

| Envelope | Plan extent |
|---|---|
| wheel +Y (**diameter in X**, width in Y) | X −9.4 … 37.4, Y 40 … 70 |
| well +Y interior (52.8 × 34.0) | X −12.4 … 40.4, Y 38.0 … 72.0 |
| well +Y seal wall outer (1.2 wall + 3.0 seal) | X −16.6 … 44.6, Y 33.8 … 76.2 |
| well −Y | **point-mirror** of the above |
| motor cheeks (both cradles, one central spine) | \|X\| ≤ 28.355, \|Y\| ≤ 33.8 |
| duct collar Ø58 at (52, 0) | X 23.0 … 81.0, Y ±29.0 |
| battery tub outer (38.4 × 110.9, rear corners chamfered 2 × 2) | X −85.0 … −46.6, Y ±55.45 |
| battery itself | X −83.8 … −47.8, Y ±53.15 |
| corner pods ×4, optical centre r 120.15 on each diagonal | 13.8 tangential × 8.6 radial |
| Board A | X 20 … 77, Y −76 … −36 (2,280 mm²) |
| Board B | X 46.6 … 78, Y 32 … 68 (1,130 mm²) |
| lid fixings ×6 | (±74, ±74) and (0, ±82) |

*The table lists the **22 principal** envelopes. The remaining six of the 28 solved are: the main
seal loop, the base collar, the 8 plenum ribs (as one envelope), the duct bore, the two knock-outs,
and the lid skirt.*

**Declared fusions — allowed, named in advance, never reported as conflicts:**

1. motor cheeks ↔ well seal walls — *that junction **is** the faceplate*
2. motor cheeks ↔ duct collar — they merge below Z 14; the motor silhouette stays inside X ±22.6
3. the two inner cheeks share one central spine
4. base collar band ↔ seal loop wall
5. **corner pod ↔ wedge shell** — *the pod **is** the wedge surface offset +2.5 mm. One envelope,
   not two.* Failing to declare this produced two of v8's twelve findings
6. **plenum ribs ↔ wedge skin** — *the ribs are supposed to touch the skin they support*

## 9.1 What changed v7 → v8, and why

| # | Change | Reason |
|---|---|---|
| 1 | Well X width 40 → **52.80** (`wheel_od + 6`), Y depth **34.00** (`tyre_w + 4`) | v7 applied `well_w` to the wrong axis. A wheel on a Y axis presents its **diameter** in X |
| 2 | Battery tub → X −85.0…−46.6, interior 36.0 × 108.5, **rear corners chamfered 2 × 2** | Without the chamfer the corner is 2.05 mm outside the lid skirt |
| 3 | Corner pod = a **uniform +2.5 offset of the wedge surface**, not a flat top | v7 had three inconsistent numbers and built a flat top whose blend hit **80°** |
| 4 | Pod carries the **bare** TCRT5000, tangential, pocket 11.4 × 6.6 *(= 13.8 − 2×1.2 tangential, 8.6 − 2×**1.0** radial — **the 1.0 radial walls are below MIN_WALL 1.2; grow the pod to 9.0 radial or cut the pocket to 6.2**)* | The whole 31 × 14 module does not fit the corner band. Desoldering is the only thing that does |
| 5 | **Wellcap posts deleted** → four M3 inserts in the well **wall tops** at Z 39 | Removes four posts from the bay; stops them bulging into the wheel |
| 6 | **Board standoffs deleted** → flush pilots + M3 nylon standoffs | Nothing stands proud of the roof except the well walls |
| 7 | Pod retention boss **hangs down** from the pocket ceiling | Same reason |
| 8 | Lid fixings (0, ±80) → **(0, ±82)** | The Ø8.5 boss overlapped the well seal wall by 0.45 mm |

---

# 10. What passed in EVERY generated build — preserve all of it

**These were never the problem. Do not redesign them.** Rows marked *(v8)* are checks that only
existed from v8 onward — they are best-achieved, not invariant.

| Check | Result |
|---|---|
| The seven RIM INSET interface radii | exact, every build |
| W1 wedge angle at 72 bearings | **15.14° ± 0.00** |
| W2 rim lip underside / rim curve fidelity | 0.51 mm / **0.000 mm** deviation |
| W3 wedge continuity rim → knee at 1° | zero gaps |
| D1 motor bottom − roof top | 0.00 |
| D2 wheel_od/2 − axle_z | 0.00 |
| D3 faceplate hole c-c, both sides | 17.00 |
| D4 cheek → tub clearance | 18.25 |
| **D5 wheel → well clearance, all four sides** *(v8)* | **3.00 / 3.00 / 2.00 / 2.00** *(conditional on `tyre_w = 30.0`)* |
| **S1 plenum flood-fill, bounded, wells excluded** *(v8)* | **Z 2.0 → 32,734 mm²** · Z 5.0 → 29,864 · Z 8.0 → 27,085 |
| **S2 open arena-floor → bay** *(v8)* | reported **39.0 mm² against a 60 cap** — **but the four permitted sensor wire holes alone are 55.7 mm². The 39.0 is unexplained and must be re-derived** |
| S3 all three skirt grooves | 2.00 deep, **0 interruptions**, 742.1 / 192.6 / 192.6 mm |
| C4 pod height uniformity *(v8)* | 2.50 at all four radii on all four pods |
| Mass, base *(v8)* | 136.2 g printed against a 175 g target |
| Mesh watertightness | **0 open edges, every part, every build** |

**The core architecture is sound.** Full-perimeter wedge, sealed plenum, drive geometry, mass — all
verified. **Every single failure in §12 is in an accessory feature bolted onto it.**

> **S1's three numbers are Z 2.0 / 5.0 / 8.0 sections, in that order.** Prior drafts printed them
> unlabelled, spanning 5,649 mm², and then quoted the largest as *the* downforce area. That is
> defensible — **the downforce area is the sealed floor footprint, which is the Z 2.0 figure** — but
> it must be labelled, because quoting the Z 8.0 figure instead gives 2.21 kgf rather than 2.67, a
> 17 % swing on the robot's headline performance claim.

---

# 11. Print reality

- **Base**: printed **upside-down, Z 10.90 roof face on the bed.** The plenum, the battery tub, the
  pod pockets and the well interiors all become upward-facing open cups needing no support. The 8
  radial ribs become free-standing walls that support removal never touches — **this matters: Den
  snapped rib legs peeling PLA support off a previous print (R20).**
- **Support is needed in exactly two places**, and prior drafts said "exactly one":
  1. under the wedge skin, an annulus 1.2–10.4 mm tall reaching the bed — tree support, Z 0.20,
     XY 0.60, 2 interface layers, 10 %;
  2. **the three seal grooves, whose mouths open downward toward the bed.** Their 45° mouth chamfers
     exist precisely so that support releases. **Scribe them clear before gluing the strips.**
- **Lid**: printed **upside-down, flat top on the bed.** The flat top is the first layer; the tower
  flares outward going down the print (self-supporting); the lip's 45° upper face is the growth face
  and its flat underside is the last layer of the lip — **a clean square catch edge.** A flat top
  printed skirt-down would be a **158 mm unsupported bridge**; a dome needs multi-stage support.
  That orientation is the entire reason the top is flat.
- **Bed**: 250 × 250 on a 256 × 256 X1C, **no brim, no skirt.** The base is exactly at the limit.
  **The only sanctioned fallback is rim semi-axis 125 → 120 — and that re-derives every radius in
  §5, drops plenum area ~8 %, and changes the mass and the wheel-well fit. It is a full re-solve.
  Decide before any layout work, not after.**
- **Do not split the base.** It is the pressure vessel.
- **Coupons before anything real**: hole shrinkage (4.00 / 4.15 / 4.30), cheek bore
  (25.1 / 25.3 / 25.5), groove (1.25 / 1.30 / 1.35). **Shrinkage coupon FIRST** — it sets
  `hole_shrink` for every other number on the bot.
- Print profile as used for the 0.82 mass factor: **PLA, 0.20 layers, 4 walls, 15 % gyroid.**

---

# 12. The failure register, v6 → v8

> **Selection rule, stated honestly:** the five rejected builds reported roughly **127 findings**
> between them (v6: 15 · v7 base: 52 · v7 lid: 31 · v7 lid rev A: 11 · v8 base: 18 constraint +
> conflict lines). **46 are listed below** — every one that is a distinct defect with a distinct
> cause. The remainder are duplicates, restatements of the same error in different checks, and
> trivia. This is a **curated register, not a complete one.** Where a heading count and a row count
> disagree, the heading is the generator's raw tally and the rows are the curated set.

**Class key** — see §13 for the full taxonomy:
`AXIS` wrong axis · `DIAG` axis value used on a diagonal · `OVER` envelopes overlapping ·
`DERIV` a derived number contradicting its own derivation · `DATUM` wrong reference face or datum ·
`LAND` not enough material/run reserved · `GAP` no minimum-clearance rule · `CRIT` the acceptance
criterion itself was wrong · `DECL` bookkeeping, not geometry

## v6 base — 15 reported, 9 distinct

| # | Failure | Class | Root cause |
|---|---|---|---|
| 1 | **Battery tub inside the −Y wheel well and wheel** | OVER | The tub was checked against the register ring and the motors, **never against the wells** |
| 2 | Seal loop at RIM INSET 18 cannot hold a 4.0 groove | **LAND** | At inset 18 the wedge skin underside is Z 5.37; a 4.0 groove needs 7.0 of wall |
| 3 | Tub ↔ motor cheek 0.00 mm; plate ↔ cheek 0.64 | DERIV | Clearances written against the **bare bore**, not the installed cheek outer face. See §15 for the corrected derivation |
| 4 | +Y bleed hole inside the ESC saddle | OVER | |
| 5 | Wellcap post inside the ESC saddle | OVER | |
| 6 | Wellcap post inside the battery tub | OVER | |
| 7 | Wellcap flange overran its stated envelope | **DECL** | The declared envelope was smaller than the part it bounded |
| 8 | Sensor wire holes pierce the plenum ceiling | — | **ACCEPTED — this is a standing design rule, not a defect.** Wire penetrations through the plenum ceiling are permitted and hot-glue sealed at assembly. They count against S2 (4 × Ø4.21 = 55.7 mm² of the 60 cap) |
| 9 | pcbplate 12.5 g against a 12 g target | **CRIT** | Target never justified. Trivial |

## v7 base — 52 reported (38 overlapping pairs), 9 distinct

| # | Failure | Class | Root cause |
|---|---|---|---|
| 10 | **Wheel does not fit its well** | **AXIS** | `well_w = tyre_w + 10` applied to X. **A wheel on a Y axis presents its diameter (46.8) in X and its width in Y.** Needed 52.8, got 40 |
| 11 | **Corner pods land on the lid joint** | **DIAG** | Pods placed at r 110–126 using axis thinking. On a diagonal the collar is 112.65–114.65 and the skirt 110.25–112.25 |
| 12 | pod_h 4.0 + pod top 14.0 + ceiling 12.80 | DERIV | Three numbers that agree at exactly one radius (r 118.03). The generator built a flat top whose blend hit **80°** |
| 13 | Pod wire hole cannot reach the bay | **DATUM** | Outboard of the knee, the pod ceiling faces **atmosphere**, not the bay. See §4.3 |
| 14 | Pod smaller than the pocket inside it | DERIV | Pod 34 × 16 outer; pocket 33 × 16 in 1.2 walls = **35.4 × 18.4**. Even before walls, a 16 pocket in a 16 pod is zero wall |
| 15 | C1 measured to the wrong face of the seal loop | **DATUM** | The loop is 3.0 thick; its inner face is 125.65, not 128.65 |
| 16 | Board B hangs off the roof | **DIAG** | Corner (−78, +88) is polar 131.55°, r 117.593, where the knee is **113.502** — overhang **4.09 mm** |
| 17 | Only 2 rib corridors of 8 fit | **LAND** | Keep-outs left almost no free angular windows. *A "rib corridor" is one of 8 radial windows, 45° apart, through which a 2.0 mm plenum rib can run without hitting a keep-out* |
| 18 | Strap slots and finger relief both "in the middle" | DERIV | Same wall, same centre, Y never pinned |

## v7 lid — 31 reported (23 constraints + 8 contradictions), 12 distinct

| # | Failure | Class | Root cause |
|---|---|---|---|
| 19 | **SK-STEP: 1.763 mm up-facing ledge, 90° overhang** | **DATUM** | Skirt at INSET 36.4 to Z 20.90; tower written as `36.4 + (Z−10.9)·tan10` — at Z 20.90 that is 38.163. **The lean datum was wrong. This one broke the entire no-support print strategy.** Fix: `Z_TOWER_DATUM = 20.90` |
| 20 | ±25° ToF have no flat seat; pilots 17.79 not 19.79 | **DIAG** | ±25° **surface normals** occur at polar **37.8°**, near the corner, where the local radius is small. A 26 mm flat pocket cannot seat there; the chord also shortened the pilot span |
| 21 | C5 counterbore depth −0.4 | **LAND** | Counterbore to 2.0 *remaining*, into a 1.6 skin |
| 22 | Hatch sill Z 11.0 cuts 9.9 mm out of the skirt | **DATUM** | "Nothing below Z 11.0" was written while the skirt runs Z 10.90 → 20.90. **Fix: sill Z 22.0** |
| 23 | **Seven clearance failures all reading 13.90** | **DECL** | The (0, ±80) fixing lugs' **16 mm pads** reach Y 72, inside the wellcap and well rectangles. The lug *centre* was declared; the *pad* was not. **One error, seven symptoms** |
| 24 | Grille inner 63.60 vs 64.0 | DERIV | Flat top Z 65.2 derived from a 1.2 skin, then built at 1.6. **Fix: flat top 65.6** |
| 25 | TTGO slot Z 24 and window Z 30 overlap by 7 mm | OVER | Two apertures where there should be one |
| 26 | Alarm window dips below the Z 38 no-hole line; lip blocks above | OVER | |
| 27 | **Group-number panel overlaps the EDF grille by 18.5 mm** | OVER | **Resolve by moving the panel. The panel is rule-mandated (R7) — do not delete it** |
| 28 | Lip "45°" vs its stated endpoints → 49.6° | **CRIT** | The tower leans away underneath. Harmless; the tolerance was too tight |
| 29 | Tower lean vs "sensor axis horizontal" | **CRIT** | A board seated flat in a leaning wall points down. Requirement and spec conflated |
| 30 | Mass 104 g vs an 85 g target | **CRIT** | Target was never justified |

## v7 lid rev A — 11 reported (10 constraints + 1 contradiction), 4 distinct *(this is the best lid we have)*

| # | Failure | Class | Root cause |
|---|---|---|---|
| 31 | **Anti-climb lip now outboard of the knee (RIM INSET 33.21)** | DERIV | Lean was changed 10° → 5° to reach the battery, **and the 6.0 lip that depended on it was never re-checked.** At 5° the tower has pulled in only 2.808 mm by Z 53 → 36.4 + 2.808 − 6.0 = 33.208, i.e. **0.79 mm outboard of the knee** |
| 32 | Rear ToF at Z 51 vs battery slit Z 22–46 + R1.5 → −3.50 | OVER | *The −3.50 figure is not reproducible from any stated extent — see §15* |
| 33 | Alarm finger hole: band left too small | **LAND** | A 30 × 20 window inside a 34 × 27 pocket leaves **2.0 mm on the long sides and 3.5 mm on the short**, against a needed 8.00. *Prior drafts said "5.50" — that was the two bands added together* |
| 34 | Board A / Board B / wellcap −Y clearances still short | OVER | |

## v8 base — 18 reported lines, 12 distinct

| # | Failure | Class | Verdict |
|---|---|---|---|
| 35 | **C3 pod slope 23.11° radial / 24.44° at a corner, vs a ≤20° constraint** | **CRIT** | Ramp gradient 0.27057 + blend 2.5/16.0 = 0.15625 → 0.42682 → **23.11°** radially; at a pod corner the two blends act on perpendicular axes → **24.44°**. Reaching 20° needs **26.77 mm** of run and C2 caps it at 16.2. **The constraint is impossible, not the geometry** |
| 36 | Pod inboard blend 16.0 mm into a 1.20 mm gap | **LAND** | Pod inner face r 115.85; knee r 114.65 |
| 37 | Retention boss Ø8.5 + 10.2 sensor needs 18.7 tangential; pocket is 11.4 | **LAND** | |
| 38 | **I5 well wall-top bosses vs P4 faceplate/well-wall thickness** | **LAND** + no single source of truth | **Diagnosed here for the first time.** I5 puts **four Ø8.5 bosses on the well wall TOPS at Z 39.0**; the same I5 (and the P4 drive block) makes those walls **1.2 mm thick**. *A Ø8.5 boss cannot sit on a 1.2 mm wall top.* **Fix: a local pad on the wall top that IS the boss, 8.5 wide, blended into the 1.2 wall over ≥ 4 mm — the same fix pattern as #21's button panel** |
| 39 | Flush board pilots as bare through-holes = **164.0 mm²** into the bay vs S2's 60 cap | DERIV | **Sourced: 8 board pilots at Ø4.15 (108.2 mm²) + the 4 permitted sensor holes at Ø4.21 (55.7 mm²) = 163.9.** *(Modelled correctly with `hole_shrink` the pilots are Ø4.36 → 119.4, total **175.1 mm²**. Either way ~3× the cap.)* Resolved correctly by the generator: **blind Ø8.5 bosses below the roof, floors Z 4.90** |
| 40 | Ø7 counterbore on a 3.0 mm ledge | **LAND** | |
| 41 | Knock-outs Ø12 at (52, ±35) exactly tangent to the Ø58 boss at (52, 0) | **GAP** | 35.0 = 29 + 6 **exactly**. Tangent apertures cannot be cut. **Fix by moving to ±36, not by deleting — see I11** |
| 42 | Ø62 pilot circle crosses the Ø58 aperture by 0.18 | **GAP** | Gap is 2.0; crossing 0.18 implies a modelled pilot of **Ø4.36 = 4.15 + 0.21 hole_shrink**, exactly as specified. **No ruling exists. Open** |
| 43 | Board B pilot (54.6, 40) lies inside knock-out (52, 35) | **GAP** | Centres **5.636 mm** apart, knock-out radius 6.0 |
| 44 | Wedge shell ↔ corner pod, 47.0 mm² × 4 | **DECL** | **The pod IS the wedge surface raised 2.5 mm. One envelope, declared as two. Not a geometry defect** |
| 45 | Wedge shell ↔ plenum ribs, 11.5 mm², depth 0.27 | **DECL** | **The ribs are supposed to touch the skin they support** |
| 46 | 1 rib corridor of 8 | **LAND** | Keep-outs leave one free window. *Same failure as #17, two generations later, still unresolved and still undefined* |

## 12.1 The v8 count, stated once and correctly

Prior drafts stated this **six mutually incompatible ways** ("two real problems away", "five of seven
are bookkeeping", "four of seven", "38 → 5, all declaration artefacts", "7 constraints 11 conflicts").
Here is the arithmetic:

> **v8 BASE has 12 distinct findings.**
> **2** are declaration bookkeeping (#44, #45) — not geometry.
> **1** was resolved correctly by the generator itself (#39).
> **9 remain open**: #35, #36, #37, **#38**, #40, #41, **#42**, #43, **#46**.
> §14 rules on six of them. **#38, #42 and #46 have no ruling anywhere and are the ones most likely
> to be shipped by accident.**

**v8 is not "two problems from passing."** It is nine, of which three are undiagnosed.

---

# 13. Why it kept happening — the taxonomy

Prior drafts offered five classes. Mapped against the register, **those five explain 17 of 46
failures (37 %)**, and two of the five have exactly **one member each** — they are anecdotes promoted
to categories. Worse: all five describe mistakes *inside the artefact*, and **none describes a
mistake in how the work was organised**, which is precisely why the same author made them four
times in a row.

Three families. The old five all live in family A.

## A. Authoring errors — what the number says

| | Class | Register members |
|---|---|---|
| **A1** | **Axis confusion on oriented parts.** A wheel spinning on a Y axis presents its **diameter** in X and its **width** in Y | #10 |
| **A2** | **Diagonal vs axis radius.** INSET 34 is r 91.00 on the axis and r 114.65 on the diagonal — a 23.65 mm difference. Interpolating between them is wrong by up to 4.88 mm | #11, #16, #20 |
| **A3** | **Over-constraint** — a value and its own derivation both stated as independent requirements | #12, #14, #18, #24, #31 |
| **A4** | **Datum / reference-face error** — which face of a 3 mm loop, which Z the tower leans from, what "below Z 11.0" means | #13, #15, #19, #22 |
| **A5** | **Envelope fidelity** — the declared envelope is not the installed volume (part + wall + heatshrink + fastener + tool access), or one envelope is declared as two | #7, #23, #44, #45 |
| **A6** | **Overlap not proven absent** | #1, #4, #5, #6, #25, #26, #27, #32, #34 |
| **A7** | **Land / run budget never reserved** — nothing overlaps, there simply isn't enough meat or enough run. **Six members; the largest unnamed class in the register** | #2, #21, #33, #36, #37, #40 |
| **A8** | **No minimum-clearance rule** — gaps of exactly 0.00, 0.18 and 0.27 mm, with nothing to flag them | #41, #42, #43 |
| **A9** | **Negative space never budgeted** — wire corridors, rib windows, airflow, tool access. Positive features were placed first; voids were whatever survived | #8, #13, #17, #46 |
| **A10** | **Underspecified degree of freedom** — "in the middle", with the axis never pinned | #18 |

## B. Criteria errors — what the pass/fail says

| | Class | Register members |
|---|---|---|
| **B1** | **Impossible acceptance criterion** — the target contradicts the geometry it judges | **#35** |
| **B2** | **Unjustified or over-tight criterion.** *Six-plus rows are the criterion being wrong, not the geometry* | #9, #28, #29, #30 |
| **B3** | **Manufacturing invariant not encoded as a check.** The no-support strategy is *why both parts are shaped as they are*, and nothing ever made "no up-facing ledge, no overhang > 55°" machine-checkable | #19 |
| **B4** | **Global budget never decomposed to features** — leak area, mass, pin count, CG were totalled but never allocated per feature | #39 |

## C. Process errors — why it happened four times

**This family had one member in the old taxonomy. This is where the repetition actually lives.**

**C1 — Change without dependency re-check.** Lean 10° → 5° fixed the flat-top reach and *instantly*
broke the 6.0 anti-climb lip (#31). Without a dependency graph you cannot know the blast radius of a
change, so the only *safe* move is to re-derive everything — which is a rewrite, which reintroduces
hundreds of hand transcriptions. **The absence of a graph is what made full rewrites feel rational.
They weren't.**

**C2 — No single source of truth.** Five live instances: the **6-vs-4 lid pilot mismatch** (I4 vs
rev A, still unresolved); #38 (two specs, one joint); #24 (skin written 1.2 and 1.6); #3 (bore vs
bore + wall); #19 (skirt Z 20.90 vs tower datum Z 10.90). Across documents too: the project's
`SumoBot_Mass_Budget.md` files the weighed 151.2 g pack under a "3S 1500 mAh" line while the label,
barcode and 24.42 Wh all say **2200 mAh** — the supplier substituted a bigger pack.

**C3 — Cross-part contract drift.** Base and lid were designed by two independent sessions with no
shared interface document. **The two surviving parts are v8 BASE and v7 LID rev A — different
generations.** #19 and #22 are both base↔lid joint failures. §7 exists to end this.

**C4 — Open-loop verification. This is the master class.** The author wrote a brief about a solid he
had never looked at, and every piece of feedback was a text panel of numbers he had himself
specified — so the loop could only confirm *the build matches the brief*. It could never say *the
brief is wrong*. The decisive evidence is in this document and went unremarked for four
generations: **the one time anyone parsed and section-cut a mesh (v5, 11 Sep), three defects fell
out that four rounds of self-check panels had never seen — including "the wheels do not reach the
ground."** That inspection was never repeated on v6, v7 or v8. #13 is the pure case: one section cut
would have shown the pod ceiling facing atmosphere.

**C5 — Scope churn.** Churn does not produce a numbered row; it produces a whole rejected
generation, so it is invisible in §12 by construction. Mid-stream: add 4 corner IR sensors, drop the
lidar, make the top flat, make it bottom-heavy, add a battery-swap slit, mount the PCB vertically,
lengthen the lip, don't snap the ribs. And silently: **the ToF count went from 3 to 6** with no
logged decision — which is what forces the PCF8574, which forces the harness gland, which is part of
what fills the roof that §16 says is too small.

**C6 — Feature-cost blindness. The strongest single finding in this post-mortem.** The corner pods
cost **eight failures** (#11, #12, #13, #14, #35, #36, #37, #44) across two generations, and they are
the sole reason the 11.00 mm diagonal band is a binding constraint at all. **A working alternative
was already documented in the project before the pods existed** — a bare TCRT5000 in a blind pocket
under the wedge skin, open only downward. *(That note quoted v5's two-slope brim at r 108; on the v8
wedge the correct radius is **RIM INSET 24.03 = r 100.98 on the axes / r 124.63 on the diagonals**,
which is where the 7.0 mm the sensor needs first exists. See §16.1.)* Nobody was ever required to
ask "what has this feature cost, and what does it buy?" — so the answer never surfaced, even though
the previous draft of this very document already said *"pods cost the most conflicts of any
feature"* and then recommended nothing.

**C7 — Requirement / specification conflation.** No brief ever separated *what it must do* from *a
number chosen to achieve that*. So a spec could be defended as if it were a requirement, and a
requirement could be deleted as if it were a number. #29 is the pure case: "sensor axis horizontal"
is a requirement; "seat the board flat in the wall" is a spec meant to achieve it; the spec was kept
and silently broke the requirement. The same mechanism deleted the **claw weapons** in eleven words
and the **knock-outs** in one ruling.

**C8 — The author was both writer and checker.** Self-review finds typos, not premises. Every
impossible constraint (#35: ≤ 20° on a 15.14° ramp) is a premise error, and premise errors are
invisible from inside. The only genuinely independent checker in the loop was the generator — which
is why the generator kept finding things.

## 13.1 The one-line diagnosis

**The design had no representation other than English prose, and prose cannot be checked.** ~100+
interdependent numbers were maintained in natural language, which has no type system, no units, no
referential integrity, and no way to ask *what depends on this*. Every consistency property had to
be held in one head, simultaneously, across a document longer than any head holds. **#12 — three
numbers that agree at exactly one radius — is not a mistake a careless person makes. It is the
mistake the medium makes inevitable.**

---

# 14. Rulings — the contradictions the generators found, and the answer to each

| Contradiction | Ruling |
|---|---|
| **C3 pod slope ≤ 20° absolute, on a 15.14° ramp** | **The constraint was wrong, not the geometry.** Restate as a **pod-relative** slope: the blend's *own* gradient ≤ 10°. Absolute slope is always ramp + blend and can never be ≤ 20° on a 15.14° ramp |
| Pod inboard blend 16.0 into a 1.20 gap | Blend inboard over the gap that **exists**, or move the pod outboard. Never state a blend longer than the space |
| Retention boss inside an 11.4 mm pocket | The boss hangs from the pod skin **outside** the pocket, at the +tangential end. *The generator resolved this correctly* |
| **Knock-outs tangent to the Ø58 boss** | **Move them to (52, ±36), giving 1.0 mm of clearance. DO NOT DELETE THEM.** The earlier "delete" ruling removed the tuneable bleed and the EDF's thermal path — see I11 and §16.2 LOST-5 |
| Board B pilot inside a knock-out | Move the pilot, or move the knock-out — both now that the knock-outs stay. 5.636 mm apart against a 6.0 radius |
| **Flush board pilots vs S2 (164 mm² vs a 60 cap)** | **Blind Ø8.5 bosses hanging below the roof, floors Z 4.90.** Roof top stays flush, plenum stays closed. *The generator got this right* |
| Ø7 counterbore on a 3.0 ledge | Plain Ø3.61 through-holes; widen the ledge to 4.0 |
| Wedge shell ↔ pods "overlap" | **Declare the pod as part of the wedge-shell envelope.** One envelope, not two |
| Wedge shell ↔ ribs "overlap" | Declared fusion — ribs support the skin |
| Lip 45° vs its stated endpoints (49.6°) | The tolerance was too tight. **45° ± 6°** |
| Tower lean vs "sensor axis horizontal" | **Wedge the pocket floor by the lean angle.** rev A did this and measured 0.0° elevation on all six |
| TTGO slot Z 24 + window Z 30 overlapping | **One aperture, not two** |
| Group panel over the EDF grille | **Move the panel.** It is rule-mandated (R7) — deleting it fails the competition brief |
| Flat top 65.2 vs a 1.6 shell | **Flat top 65.6** with a 1.6 skin gives inner 64.00 exactly |
| Hatch sill Z 11.0 cutting the skirt | **Sill Z 22.0** — above the skirt top at 20.90 |
| SK-STEP 1.763 mm ledge | **`Z_TOWER_DATUM = 20.90`.** The analytic step becomes exactly **0.000** |
| Alarm finger hole band | The 30 × 20 window in a 34 × 27 pocket leaves 2.0 / 3.5. **Either shrink the window or grow the pocket — both axes need a different fix** |
| **#38 Ø8.5 bosses on a 1.2 mm well wall top** | **RULED HERE: a local pad on the wall top that IS the boss** — 8.5 wide, blended into the 1.2 wall over ≥ 4 mm, so the wall thickness and the boss diameter are one number, not two |
| **#42 Ø62 pilot circle vs Ø58 aperture** | **NO RULING EXISTS. Open.** Ø62.5 is not enough — it leaves 0.07 mm against MIN_GAP 0.8. Move the bolt circle to **≥ Ø63.96**, or shrink the aperture |
| **#31 anti-climb lip outboard of the knee (INSET 33.21)** | **RULED HERE.** It violates I3's *"no lid surface is ever radially proud of the base"* and CHK-SK3. At 5° lean a 6.0 lip cannot fit; the lip proudness is capped by `36.4 + (53 − 20.90)·tan(lean) − 36.4 = 2.808` at 5°, so **max lip = 0.4 mm** — useless. **Either go back to 10° lean (gives 5.66 mm of pull-in by Z 53, so a 3.2 lip fits) or move the lip up to Z 60+ where more pull-in has accumulated.** Settle DEC-14 first |
| **#21 / CHK-C5 button panel: counterbore to 2.0 remaining in a 1.6 skin** | **RULED HERE: a local pad on the flat top's underside whose TOTAL thickness IS `btn_panel_t`**, blended into the 1.6 skin — so the panel thickness is one number, not a skin minus a counterbore. Same fix pattern as #38 |
| **#46 one rib corridor of eight** | **NO RULING EXISTS. Open, and the same failure as #17 two generations earlier.** Define what a rib corridor is, state how many are required and why, and budget them as envelopes |

---

# 15. Corrections — numbers previously stated as fact that are wrong

**Every figure below was independently recomputed. Where an earlier document disagrees, this table
wins.** Several of these were quoted in the v6/v7/v8 briefs.

## 15.1 Would cause a wrong build

| Claim as previously stated | Correct value | Consequence of using the old one |
|---|---|---|
| "Superellipse corner radius **~5 mm** at Z 48" | **The rim corner radius is 49.550 mm and falls as `49.550 − inset`.** At the ToF band the tower's local radius is **6.6–10.8 mm at the 45° corner** and **20.3–24.5 mm where the sensor actually sits** (25° normal, polar 37.8°) | 5 mm is **geometrically impossible** for the quoted chords — a 12 mm chord cannot exist on a 5 mm radius. Anyone sizing a pocket from it cuts 3–6 mm into a 1.6 mm skin |
| "A 26 mm flat pocket falls **3.69 mm**; a 12 mm one falls **0.95 mm**" | **26 mm → 6.8–9.3 mm. 12 mm → 1.1–1.8 mm** | The two old numbers imply *two different* radii (24.75 and 19.42) — they were never computed from one geometry. **The conclusion "mount ToF boards long-axis vertical" is right, and the case for it is ~2.3× stronger than stated** |
| "A 31 × 14 TCRT module needs **16.4** radial" | **19.81 mm** at the knee | 16.4 was the sagitta computed on the **rim** (R 49.55), not at the knee (R 15.55). *Conclusion unchanged: it still does not fit in 11.00* |
| "A bare 10.2 × 5.8 sensor needs **8.2** radial" | **6.58 mm** at the knee | The same +2.4 constant was reused; the correct sagitta for a 10.2 chord is 0.78, not 2.4. **The bare sensor has 4.4 mm to spare, not 2.8** — do not trim the collar to recover a gap that already exists |
| "S1 = 32,734 / 29,864 / 27,085 mm²" *(unlabelled)* | **Z 2.0 / Z 5.0 / Z 8.0, in that order.** Downforce uses the **Z 2.0** figure | Quoting the smallest gives 2.21 kgf instead of 2.67 — a **17 % error on the headline performance number** |
| "**800 Pa**" filed under *hard geometric facts* | **An unmeasured assumption.** Moved to §6.2 | The mid-Sep kill gate is 0.9 kgf = **270 Pa**. The design claims 3× the survival threshold from a number nobody has measured, against an explicit coordinator warning about side leaks |
| "#3: bore 26.65 + 1.6 wall = **28.355**" | **28.355 is the cheek OUTER FACE in absolute X, not a bore+wall sum**: `(25.3 + 0.21)/2 + 1.6 + 14.0 = 28.355`. 26.65 was the v6 bore for the *assumed 371-class* motor and is retracted | Written as stated it doesn't close (26.65 + 1.6 = 28.25; + 2 × 1.6 = 29.85). If any v8 clearance was written against a diameter reading, there is a live ~1.5 mm interference |
| "#39: **164 mm²**" *(unsourced)* | **Sourced: 8 board pilots at Ø4.15 (108.2) + 4 sensor holes at Ø4.21 (55.7) = 163.9 mm². Modelled with `hole_shrink` (Ø4.36) it is 175.1** | The ruling (blind bosses) is correct and **necessary** — this is a 173 % breach of the 60 cap, not a rounding issue |
| "#33: **5.50 mm** band left" | **2.0 mm on the long sides, 3.5 mm on the short** | The old figure added the two bands. Against a needed 8.00 the shortfalls are 6.0 and 4.5 — **the feature is much further from viable than recorded, and the two axes need different fixes** |
| "v8's BASE is two real problems away" | **Nine open, three of them without any ruling** | A session starting from the old draft's summary would believe the base is nearly done and ship #38, #42 and #46 |
| "base 136 g + lid 110 g = 246 g, ~21 g recovered vs v5's 267 g" | **136.2 + 104 + 2 wellcaps (16) + hatch (8) ≈ 264 g. No meaningful recovery. Ballast headroom stays ~23 g** | Over-optimistic mass planning on a design whose whole strategy is ballast |

## 15.2 Verified correct — use with confidence

| Claim | Computed | |
|---|---|---|
| The full seven-row radius table, all 14 values | exact to 0.001 | **PASS** |
| `r_diag = 148.65089 − d`, `r_axis = 125 − d` | exact | **PASS** |
| Offset curve cusping | **none** — self-intersection only begins at inset 49.55; deepest used is 38.4 | **PASS** |
| Seal-groove main-loop length 742.1 mm | **742.124** at INSET 21.5 — *this single number independently validates the whole superellipse model* | **PASS** |
| tan(15.14°) = 0.2705 | 0.27057 | PASS *(print 0.2706)* |
| Pod slope 0.27057 + 0.15625 = 0.42682 → **23.11°** | 23.113° | **PASS** |
| "Reaching 20° needs 26.8 mm of run" | 26.766 | **PASS** |
| SK-STEP = 36.4 + 10·tan10° − 36.4 = **1.763** | 1.76327 | **PASS** |
| rev A's corrected step | **analytically 0.000.** The reported 0.018 is a tessellation artefact of a ~176-segment curve (0.09 of a layer). Report it as 0.000 with a note — **do not let anyone "fix" a defect that isn't there** | — |
| Lip: (53 − 20.90)·tan5° = **2.808**; 36.4 + 2.808 − 6.0 = **33.208** | identical | **PASS** — outboard of the knee by 0.79 |
| Sign convention: **smaller RIM INSET = further out** | consistent everywhere in every document | **PASS** |
| 0.82 print factor from 267 / 324.5 | 0.8228 | **PASS** |
| 32,734 mm² × 800 Pa = 26.19 N = **2.67 kgf** | identical | **PASS arithmetic** (input assumed — see above) |
| ToF: 6 × 25° = 150° of 360 = **41.7 %**; blind arcs 37.5–77.5° and 102.5–167.5° each side | exact, from bearings [0, ±25, ±90, 180] | **PASS** |
| Alternative [0, ±25, ±50, 180] → continuous **−62.5…+62.5 = 125°** front arc | exact | **PASS** |
| #41 tangency: 58/2 + 12/2 = 29 + 6 = 35.0 exactly, with the Ø58 boss at (52, 0) | confirmed — the boss **is** at (52, 0) | **PASS** |
| #42: crossing 0.18 implies a modelled pilot of **Ø4.36 = 4.15 + hole_shrink** exactly | confirmed | **PASS** |
| #14: 33 + 2(1.2) = 35.4; 16 + 2(1.2) = 18.4 | identical | **PASS** |
| "158 mm unsupported bridge" | **WITHDRAWN — 158.06 came from the retired Z 10.90 datum.** Correct: flat top Z 65.6 meets the tower at RIM INSET 44.282 → **161.44 mm** across the axes at 10° lean, **169.38 mm** at 5° | **FAIL**, figure replaced |
| Blend composition: summing **gradients** (not angles) | correct, because the 16.0 blend run is horizontal so heights and therefore derivatives add. *Summing angles gives 24.02°; all readings exceed 20°, so the verdict is unaffected* | — |

## 15.3 Minor corrections

- "#2C: the battery is **33 mm** too long" → **31.29 mm**.
- "#16: the knee there is 114.0, overhang 3.59" → **knee 113.502, overhang 4.09 mm**.
- "#43: centres 5.63 apart" → **5.6356**.
- "#35: 25.23° at a pod corner" → **24.44°**. *(25.23 is not reproducible by any route from 0.27057 and 0.15625.)*
- "Support is needed in exactly one place" → **two** (the wedge annulus **and** the three seal grooves, whose mouths face the bed).
- "v5 took three revs" → the list given has **four** (rev1 → 2 → 2.1 → v5.3).
- **#32's −3.50 mm is not derivable from any stated extent.** Nearest reconstructions give −1.66 or −8.89. Re-derive before trusting it.
- **The earlier draft's PCF8574 area figures (6,700 → 2,430 mm²) are not derivable from any stated module size.** Treat as an estimate.
- The earlier draft's "free roof: 13,116 mm² total, largest single rectangle 2,700 mm²" argument is stated in **areas only**. *Area does not tell you whether a board fits* — the free rectangle needs both its dimensions. The whole "electronics fit if you use one PCF8574" conclusion is currently unverifiable.

---

# 16. Feature ledger, lost features, and open decisions

## 16.1 The feature ledger

**Rule: any feature at ≥ 3 conflicts must be re-justified in writing against the requirement it
serves, or deleted.** Nobody ever ran this, which is why the pods survived two generations.

| Feature | Serves | Conflicts caused | Cheapest alternative serving the same requirement | Verdict |
|---|---|---|---|---|
| **Corner pods ×4** | R12 line detection | **8** (#11 #12 #13 #14 #35 #36 #37 #44) | **Bare TCRT5000 in a blind under-brim pocket, open only downward** — **recompute the radius before using it.** The v8 wedge underside is `Z = 0.50 + 0.27057 × inset`, so the 7.0 mm a bare sensor needs first exists at **RIM INSET 24.03 → r 100.98 on the axes, r 124.63 on the diagonals** — comfortably inboard of the seal loop (INSET 20–23) and outboard of the knee. *The old "r 108, ~8 mm tall" note was v5 brim geometry; at r 108 on this wedge only 5.10 mm is available.* | **DELETE THE PODS**, mount at INSET 24.03. This is the single highest-leverage decision available |
| Knock-outs ×2 | Tuneable bleed + EDF thermal path | 3 (#41 #42 #43) | none — *nothing else provides a tuneable bleed* | **KEEP, move to (52, ±36)** |
| 6 ToF (was 3) | R11 opponent finding | drives the PCF8574, the gland and the roof-area crunch | 3 ToF at 0°, ±30° (the original plan) | **Open — decision D6** |
| Battery hatch | **R16** | 2 (#22 #32) | none — R16 is a stated requirement | Keep, sill Z 22.0 |
| Anti-climb lip | **R14** | 2 (#28 #31) | none — R14 is the actual loss mode | Keep |
| Group panel + LED | **R6, R7 — rule-mandated** | 1 (#27) | none | **Keep. Move the panel** |

## 16.2 Features that were lost without a decision being recorded

| | Feature | What happened | Why it matters |
|---|---|---|---|
| **LOST-1** | **Claw wedges** (front/rear) | Present on v5's cover; absorbed into the base's continuous 360° wedge in v6 and logged in **eleven words** | They were "the weapons — scoop under the opponent, hold them". **The bot changed from flip-capable to push-only, and the competition brief's win condition is "push it outside OR flip it over."** The rationale for deleting them does exist (the base has no rim for 164° of perimeter in the claw sectors) — it just was never written where anyone would read it. **Confirm this deletion is intended** |
| **LOST-2** | **ToF count 3 → 6** | Changed silently between the handoff doc and v7 | Drives the PCF8574 count, the harness gland, and the roof-area crunch. DEC-6 asks about *layout* and never about *count* — the expensive question |
| **LOST-3** | **Lidar** | Dropped at Den's instruction, 11 Sep — "takes too much weight" | Correctly dropped. Recorded here so nobody re-adds it |
| **LOST-4** | **Ballast pockets** | Defined in the CAD brief (2 × 24 × 40 × 12, M3 stud, at (−42, 45) and (42, −45) — the only low, flat, point-symmetric spots). **Gone from v6, v7 and v8 with no note.** The v8 brief says outright "No ballast pockets" | **"Ballast is the strategy"** and headroom is ~23 g. Deleting the only place to put ballast, on a bot whose plan is to run at 990 g, is a significant silent decision |
| **LOST-5** | **Knock-outs / tuneable bleed** | Ruled "delete" in v8 as "a tuning option that may never be used" | **It is the answer Den gave the course coordinator** when warned the competition timber plate is not smooth and to expect side-leak losses. It is also the EDF's only thermal relief into the bay. **A ruling reversed a commitment made to staff and recorded it as a tidy-up** |
| **LOST-6** | **"Cutouts for the arrows"** | Den mentioned it once; never clarified; never implemented | Ask what this means |
| **LOST-7** | **The 80 mm ESC lead constraint** | The *measurement* (80 mm power leads) survives in §6.1; the *constraint it implies* — **the ESC must sit within ~60 mm of the PDB, verify before cutting** — was lost | A derived constraint can be lost while its source fact is kept. Watch for this pattern |

## 16.3 Open decisions

| # | Decision | What it blocks | Recommendation |
|---|---|---|---|
| **DEC-1** | **Measure `tyre_w`** | The well, the wellcap, and D5's validity | do it |
| **DEC-2** | **Measure `btn_panel_t`** | The button mount entirely | do it |
| **DEC-3** | **Measure the bare TCRT5000** | 0.10 mm of margin on a datasheet figure | do it |
| **DEC-4** | **Weigh the motors** | 190 g = 20 % of the robot, on a seller estimate | do it |
| **DEC-5** | **Confirm the PCF8574 count** | Whether the boards fit at all | one, not four |
| **DEC-6** | **ToF count and layout.** 6 at `[0,±25,±90,180]` (41.7 %, three arcs) · 6 at `[0,±25,±50,180]` (continuous 125° front) · **or back to 3 at `[0,±30]` as originally planned** | Board area, pin budget, lid apertures, tower geometry | **Ask the count first.** 3 removes the PCF8574 pressure entirely |
| **DEC-7** | **Corner pods: keep or delete** | Eight conflicts and the 11.00 mm band | **Delete. Use an under-brim blind pocket** |
| **DEC-8** | **6 lid pilots or 4** | The base↔lid joint. Base I4 drills **6**; lid rev A uses **4**. **Unresolved** | **Six. Freeze it in §7 and rebuild both parts against it** |
| **DEC-9** | Bed check: 250 × 250 with no brim/skirt | Whether the fallback (rim 125 → 120) is needed | **Check before layout** — the fallback re-derives everything |
| **DEC-10** | Restore the ballast pockets? | ~23 g of headroom and the whole ballast strategy | Probably yes |
| **DEC-11** | Confirm the claws are intentionally gone | Flip capability | ask |
| **DEC-12** | What are "the arrows"? | An unimplemented request | ask |
| **DEC-13** | **⚠ THE BATTERY HATCH DOES NOT WORK AS SPECIFIED — R16 is currently unsatisfiable** | Battery access, the whole rear of the lid | **See §16.4. Ruling needed before either part is generated** |
| **DEC-14** | **Tower `lean`: 10° or 5°?** No value is recorded anywhere as *the* value. v7/v8 used 10°, lid rev A used 5° to reach the battery | The tower profile, the flat-top width, the bridge length, the anti-climb lip (#31), the ToF seat angles — **everything above Z 20.90** | **10°.** 5° was adopted to solve a battery-access problem that DEC-13 has to solve differently anyway |

## 16.4 ⚠ THE BATTERY HATCH DOES NOT WORK — the one live, unresolved blocker

**R16 ("battery swappable without removing the lid") cannot be satisfied by the current spec, and
this was not noticed until the final review of this document.** The arithmetic:

| | |
|---|---|
| Battery sits (I9) | **Z 3.90 … 25.36** |
| Battery tub walls stop at (I9) | Z 13.0 — *so the pack can lift out of the tub after 9.1 mm* |
| Hatch sill, after #22's ruling | **Z 22.0** (it must clear the lid skirt, which runs Z 10.90 → 20.90) |
| Lift needed to get the pack's underside above the sill | **18.1 mm** |
| Headroom above the pack (I12: lid inner ≥ 28.0 over the tub) | **2.64 mm** |

**The pack cannot be raised far enough to pass over the sill.** The original sill at Z 11.0 worked
geometrically and cut 9.9 mm out of the lid skirt — that is failure #22, and "sill Z 22.0" fixed the
skirt by breaking the requirement. **Neither position works. This needs a ruling before either part
is generated.** Three options:

1. **Frame the aperture through the skirt.** An opening above Z 10.90 costs **zero downforce**
   (§4.3 — the bay is already at ambient), so the skirt here is structure, not seal. Keep the sill at
   Z 11.0 and run a 3 mm boxed frame around the aperture to restore the hoop stiffness the skirt
   provided. *Cheapest, and it is the only option that keeps the pack where R17 wants it.*
2. **Raise the battery tub** so the pack's underside sits at Z 22.0. Costs **18 mm of CG height** on
   the heaviest single item — directly against R17, and it eats the bay.
3. **Drop R16.** Swap the battery by removing the lid (6 × M3). Between bouts there is time; mid-bout
   there is not. Ask first — Den asked for this feature explicitly and it is the only requirement here
   that came from him rather than from the competition brief.

**Recommendation: option 1.** It was rejected in v7 only because "cuts the skirt" was read as a seal
failure when it is not one.

---

# 17. The method for the next session

## 17.0 Stage zero — ask whether to do this at all

Before any CAD: the fan kill gate is **next week** and the first drive is **ten days away and
needs only a rolling platform.** A rolling platform is the base's drive geometry (cheeks, wells,
faceplates, wheels) and nothing else — no plenum seal, no lid, no ToF, no pods, no fan.

**Consider printing a drive-only base first and banking the first drive.** Everything in §7 survives that
decision; it just gets built in two passes instead of one.

## 17.1 Stage 1 — `REQ.md`
Numbered requirements only, each with: `ID | requirement | source | verification method | owner`.
Rule-mandated first and marked non-negotiable. **§2 of this document is the draft, to be confirmed before the build.**
**Done when** every requirement has a verification method and every feature you intend to build names
a REQ id. *A feature with no REQ id is deleted, not discussed.*

## 17.2 Stage 2 — `params.py`, the single source of truth
Three sections exactly as §6: `MEASURED` (with provenance and date) · `ASSUMED` (each with the test
that retires it) · `DERIVED` (**expressions only, zero literals**). Plus `check_params()` asserting
`MIN_WALL 1.2`, `MIN_GAP 0.8`, `MIN_LAND 1.5`, `MAX_OVERHANG 55°`, bed and mass ceilings.
**Done when** `python params.py` prints the full derived table and exits 0.
*This makes A3, A7, A8 and part of A4 structurally impossible — **sixteen** register entries.*

## 17.3 Stage 3 — `envelopes.py`, the layout solver. **This is a gate, not a step.**
Every object is `Envelope(id, solid, z_range, fusions=[], req=[])`, with two hard rules:

- **The solid is the INSTALLED volume**, not the part: part + wall + heatshrink + fastener + driver
  access cone + service swing. *#3, #7 and #23 all die here.*
- **Negative space is declared as envelopes too**: wire corridors, the 8 rib windows, plenum flow,
  battery-swap swing, insert tool access. *#8, #13, #17 and #46 all die here.*

Then extend v8's raster **beyond overlap**. At 0.5 mm compute: pairwise overlap (zero outside
declared fusions) · **min gap** every non-fused pair ≥ 0.8 · **min wall** every cavity-to-surface
≥ 1.2 · **min land** around every hole and counterbore ≥ 1.5 · **absolute slope and overhang** at
every blended face · **leak area per feature** against the S2 cap · **mass and CG** from the voxels.
**Done when** everything is green, every fusion is named *in advance*, and leak/mass/CG are
allocated per feature rather than only totalled.

## 17.4 Stage 4 — freeze `INTERFACE.md`
**§7 of this document is it.** Version it. Both briefs `include` it verbatim. Neither session may
change a number in it; a change is a contract revision and both parts rebuild. *C3 dies here, along
with #19, #22 and D8.*

## 17.5 Stage 5 — the brief is **rendered, not written**
A template that pulls every number from `params.py` and `envelopes.py`. Prose carries intent and REQ
ids only. Each constraint block reads: `REQ-id | the number | where the number came from | the check
that verifies it`. **Done when** `grep` finds no numeric literal in the brief that isn't printed from
the model. *A1, A2, A3 and A4 cannot recur.*

## 17.6 Stage 6 — patch, never rewrite
**The most transferable result of the entire day, and it was one line in the old draft:** v7 lid
rev A used a **modification block into the same chat** — 14 targeted changes — and took the lid from
**23 constraint failures to 10** (31 total findings to 11), **at a fraction of the cost of a rewrite.** Every full rewrite made
things worse or sideways. Default to a patch. A fresh build only when the architecture changes.
Before any parameter change, **print its dependents from the graph** and state which checks re-run.

## 17.7 Stage 7 — close the visual loop. **The stage that never existed.**
Export the mesh. Section-cut at X = 0, Y = 0, the 45° diagonal, and Z at the roof. Render six views.
**Look at them.** This is not optional — it is the only step in the entire project history with a
proven hit rate: **one sitting, three defects, including "the robot does not touch the ground."**
**Done when** Den has seen 6 renders and 4 sections and said yes — *not* "read the panel and said yes."

## 17.8 The human loop, kept cheap
Den gets three question types, each ≤ 5 minutes, and **never a 100-number brief** — he cannot check
one and neither can the author:

1. **After stage 1:** one screen. *"Here are the requirements and the three features about to consume
   budget. Cut anything?"*
2. **During stage 3, only on a genuine conflict:** *"X and Y cannot both exist. A costs this, B costs
   that. Pick."* A choice, not a puzzle.
3. **After stage 7:** the pictures. *"Is this the robot you want?"* A look, not a read.

## 17.9 What to hand the next CAD session

1. **§7** (interface contract) — verbatim, both prompts.
2. **§9** (the verified v8 layout table) — as the starting layout, not a reference.
3. **§8** (the check register) — as the self-check spec.
4. **§6** (parameters) — as `params.py`.
5. **§15** — so it does not inherit the wrong corner radius.
6. **§16** — so it knows what was deleted and why, and what is still undecided.

---

# Appendix A — Version history and the v5 mesh forensics

| Version | What it was | Outcome |
|---|---|---|
| **v5** | Sombrero shell: Ø250 squircle base with a 14° brim, plus a separate cover carrying front/rear claw wedges. **Printed. Chassis weighed 267 g** | Worked as an object. Took three revs (rev1 → 2 → 2.1 → v5.3) to get the cover to seat |
| **v5 analysis, 11 Sep** | Den uploaded both 3MFs. Meshes parsed and section-cut directly | **Found three defects that four rounds of self-check panels never saw** |
| **v6** | Full rewrite. Base owns a continuous 360° wedge; the cover shrinks to a lid | Built clean. 15 findings, 9 distinct |
| **v7 base** | Rewrite with a mandatory plan-overlap preflight | Built clean. **38 overlapping pairs** |
| **v7 lid** | First lid attempt | 31 findings (23 constraints + 8 contradictions), 12 distinct, incl. the 90° print ledge |
| **v7 lid rev A** | **Modification block, 14 changes, same chat** | 11 findings (10 constraints + 1 contradiction), 4 distinct. **Best lid we have.** The ledge was fixed |
| **v8 base** | Rewrite from a **pre-solved, numerically verified layout table** | 18 lines, 12 distinct, **9 still open** |

## A.1 The v5 mesh findings, in full

Measured directly off `sumo_v5_housing.3mf` / `sumo_v5_cover.3mf` by parsing the 3MF object XML,
ray-casting with spatial binning, taking plane sections and flood-filling.

| | Finding | Number |
|---|---|---|
| **A** | **Both wheel wells were open holes straight to the arena floor, inside the seal loop.** The well walls existed only from Z 9.7 up. A tyre blocks only its contact patch | **3,599 mm² open** vs a 382 mm² design skirt leak — **9.4×** |
| **B** | **The wheels did not reach the ground.** Saddle floor Z 13.35 + a Ø25 can → axle at Z 25.85; measured wheel OD with tyre 46.80 → radius 23.40 | **Wheel bottom at Z +2.45.** The bot rode on its rim and skirt |
| **C** | **The new battery did not fit.** Ovonic 3S 2200 mAh measures 106.29 × 34.39 × 21.46 against a 75 mm bay | **31.29 mm too long** |
| **D** | Printed-mass calibration: STL volume × 1.24 = 324.5 g solid, against a weighed 267 g | **printed = 0.82 × solid.** Used everywhere since |
| **E** | Plenum flood-filled at Z 7 | 30,217 mm² nominal, 26,404 mm² sealed ceiling |

**Consequence: the fan, the ESC, the 30 A wiring and the battery upgrade were producing
approximately zero downforce, and the bot was not rolling on its tyres.** That is what justified the
rewrite — and it is the single strongest argument in this document for stage 7.

---

# Appendix B — The sampled radius table

**Use this, or generate the curve (§5.2). Never interpolate between the axis and diagonal columns.**

`r` in mm, by **polar angle**, for each RIM INSET. One quadrant; the rest is by symmetry.

| polar° | 0 (RIM) | 20.0 | 23.0 | **34.0 (KNEE)** | 36.0 | 36.4 | 38.4 |
|---|---|---|---|---|---|---|---|
| 0 | 125.000 | 105.000 | 102.000 | **91.000** | 89.000 | 88.600 | 86.600 |
| 5 | 125.476 | 105.400 | 102.389 | **91.347** | 89.340 | 88.938 | 86.930 |
| 10 | 126.898 | 106.604 | 103.560 | **92.395** | 90.365 | 89.959 | 87.929 |
| 15 | 129.243 | 108.620 | 105.523 | **94.162** | 92.096 | 91.683 | 89.616 |
| 20 | 132.445 | 111.441 | 108.280 | **96.670** | 94.556 | 94.133 | 92.018 |
| 25 | 136.338 | 115.017 | 111.794 | **99.924** | 97.758 | 97.325 | 95.155 |
| 30 | 140.585 | 119.176 | 115.919 | **103.866** | 101.656 | 101.213 | 98.996 |
| 35 | 144.596 | 123.501 | 120.275 | **108.264** | 106.046 | 105.601 | 103.371 |
| 40 | 147.551 | 127.127 | 124.023 | **112.463** | 110.320 | 109.890 | 107.728 |
| 45 | 148.651 | 128.651 | 125.651 | **114.651** | 112.651 | 112.251 | 110.251 |

**Local radius of curvature** at inset `d`: `R = 49.550 − d` at the 45° corner (flat, R → ∞, on the
axes). Sagitta of a chord of width `w`: `w²/8R`.

**Worst case for linear interpolation between the 0° and 45° columns: 4.88 mm error, at polar 18.5°,
on the knee curve.** That is failure #16.

---

# Appendix C — Glossary

Terms used throughout, several of which collide with each other and were never defined.

| Term | Means |
|---|---|
| **RIM** | The outer superellipse, 250 × 250, at the arena floor |
| **RIM INSET d** | That curve offset `d` mm inward **along its local normal** |
| **WEDGE** | The continuous 360° 15.14° ramp from the rim up to the knee. The primary structure |
| **KNEE** | RIM INSET 34.0 at Z 10.90 — the sealed boundary and the base/lid divide |
| **PLENUM** | The sealed cavity under the roof (Z 1.50…9.70), evacuated by the EDF |
| **BAY** | The volume above the roof (Z 10.90 up) carrying the electronics. **At ambient pressure** |
| **ROOF / roof plate** | The flat plate Z 9.70…10.90 separating plenum from bay |
| **SEAL SKIRT** | The silicone strip in the groove that wipes the arena floor. *Three loops: one main, one per well* |
| **LID SKIRT** (a different thing) | The lid's **vertical wall**, INSET 36.4…38.4, Z 10.90…20.90 |
| *slicer* **brim/skirt** (a third thing) | The slicer setting. The base must fit 250 × 250 **with neither** |
| **COLLAR** | The base's upstanding wall, INSET 34.0…36.0, Z 10.90…16.90, that the lid skirt drops inside |
| **TOWER** | The lid's leaning wall above Z 20.90 |
| **FLAT TOP** | The lid's top plane at **Z 65.6** (65.2 is retired — it assumed a 1.2 skin). *(#12 also used "flat top" for a pod's top face — that usage is retired)* |
| **ANTI-CLIMB LIP** | The 6.0 mm proud ledge at Z 53, flat underside, 45° upper face. Serves R14 |
| **WELL** | A wheel well: a sealed box open to the arena below, capped above |
| **WELLCAP** | The separate printed box that caps a well against the bay |
| **CHEEK** | One side of a motor cradle — a half-round bore wall. Two per motor |
| **FACEPLATE** | The well's inner wall where the motor bolts through, 17.00 c-c |
| **TUB** | The battery tub |
| **POD** | A corner pod — the wedge surface offset +2.5 mm, carrying a line sensor |
| **DUCT / COLLAR** | The Ø58 EDF mount at (52, 0) |
| **KNOCK-OUT** | A Ø12 membrane disc in the roof, drilled out only if bleed tuning is needed |
| **RIB CORRIDOR** | One of 8 free 45°-spaced angular windows through which a 2.0 mm plenum rib can run |
| **BLEED** | A deliberate plenum leak, used to tune the EDF's operating point |
| **BOARD A / BOARD B** | Power board (carries the ESC) / logic board (carries the TTGO). See I7, I8 |
| **HATCH** | The removable rear panel for battery access |
| **"rev A"** | A **modification block patched into an existing CAD chat**, as opposed to a fresh build |
| **SK-STEP** | The check for a step between the lid skirt and the tower at Z 20.90 |

---

*Written 11 Sep 2026. The geometry in §5, §9 and Appendix B was independently recomputed; §15 lists
every figure that changed. Sections 2, 3, 4, 7, 8 and 16 did not exist in any earlier document.*
